SIRIO-VENTILATOR/sirio-hardware/SIRIO v5 INDUSTRIAL/JPG/SIRIO_3D_jpg.JPG

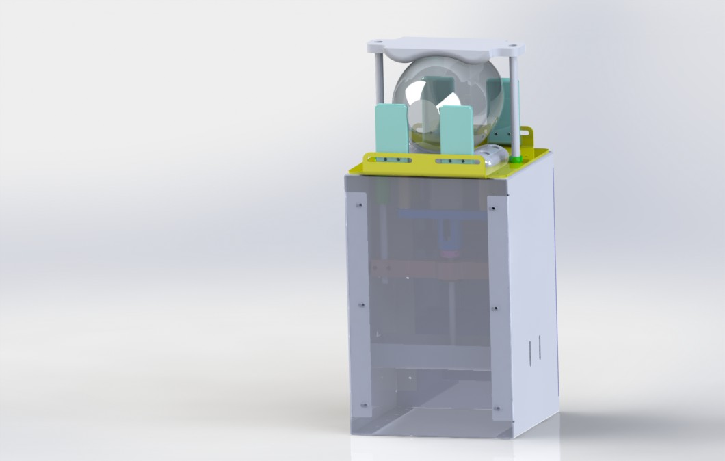
SIRIO v5 INDUSTRIAL/JPG/SIRIO_3D_jpg.JPG
