SIRIO-VENTILATOR/sirio-hardware/SIRIO v5 INDUSTRIAL/JPG/SIRIO_3D_v5_LATERAL.JPG

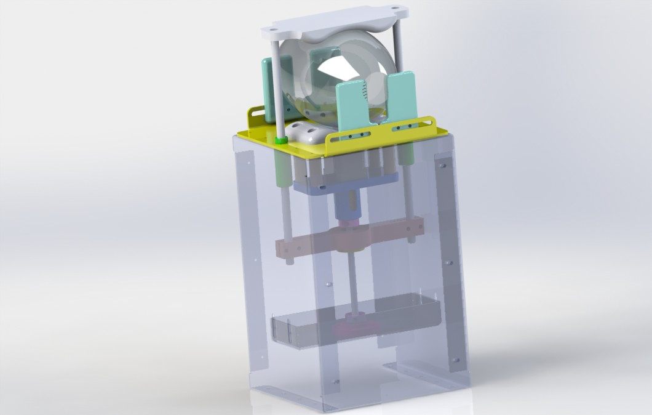
SIRIO v5 INDUSTRIAL/JPG/SIRIO_3D_v5_LATERAL.JPG
