SIRIO-VENTILATOR/sirio-hardware/SIRIO v5 INDUSTRIAL/BOM.md

## INDUSTRIAL VERSION

# BILL OF MATERIALS
