SIRIO-VENTILATOR/sirio-hardware/SIRIO v5 MAKER/STL/MAIN ARM.stl

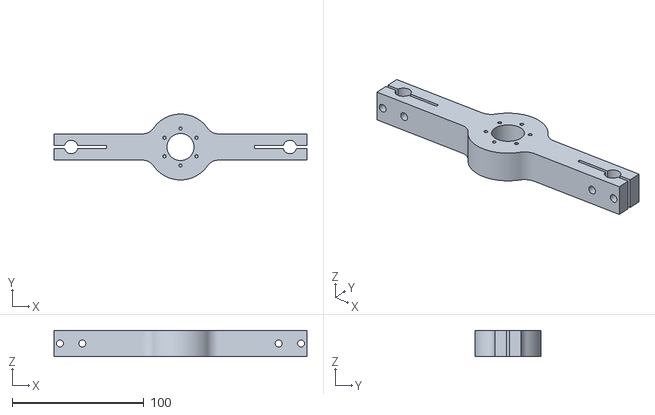
[picture p4: CAD file, 2020-03-29]
SIRIO v5 MAKER/STL/MAIN ARM.stl
192.0 x 50.0 x 20.0
