SIRIO-VENTILATOR/sirio-hardware/SIRIO v5 INDUSTRIAL/SOLIDPART/SIRIO_3D_3.SLDASM

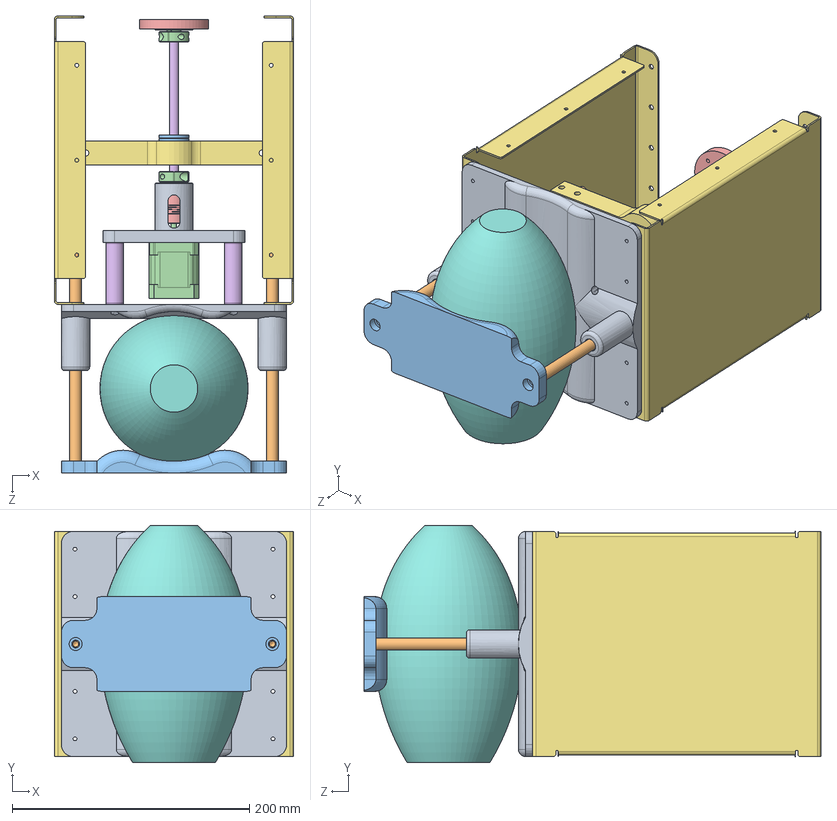
[picture p5: CAD file, 2020-03-29]
SIRIO v5 INDUSTRIAL/SOLIDPART/SIRIO_3D_3.SLDASM
202.0 x 200.0 x 385.6 mm
cuerpo
GUIA x 2
SOPORT_HUSILLO_SUP
Nema17Motor - Copy
Acople FlexibleSLDPRT_Predeterminado
HUSILLO_IGUS_8X15
SOPORTE HUSILLO
AMBU125
SOPORTE_MOTOR
ROD_608 x 2
DST_JFRM_1315DS6_35x25_4_1
collarin x 2
SOPORTE_INFERIOR_HUSILLO
SEPARADOR CILINDRO x 4
LATERAL CAJON x 2
