SIRIO-VENTILATOR/sirio-hardware/SIRIO v5 INDUSTRIAL/SOLIDPART/SIRIO_3D_v5.SLDASM

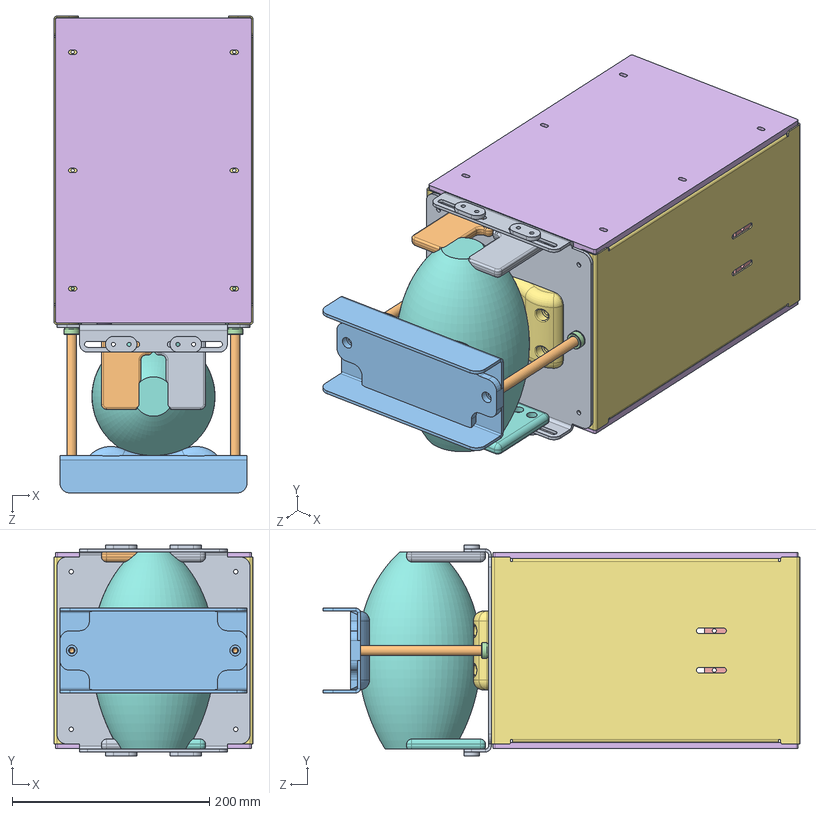
[picture p6: CAD file, 2020-03-29]
SIRIO v5 INDUSTRIAL/SOLIDPART/SIRIO_3D_v5.SLDASM
202.0 x 214.0 x 484.2 mm
cuerpo
GUIA x 2
SOPORT_HUSILLO_SUP
Nema17Motor - Copy
Acople FlexibleSLDPRT_Predeterminado
HUSILLO_IGUS_8X15
SOPORTE HUSILLO
AMBU125
SOPORTE_MOTOR
ROD_728 x 2
DST_JFRM_2020ds8x15
collarin x 2
SOPORTE_INFERIOR_HUSILLO
SEPARADOR CILINDRO x 2
LATERAL CAJON x 2
CENTRADOR
SimetríaCENTRADOR x 2
SimetríaSimetríaCENTRADOR
EMPUJADOR
CAÑONERA x 2
BASE DE HUSILLO
TAPA TRASERA x 2
EMPUJADOR_INFERIOR
TAPA FRONTAL
FIJACION CENTRADOR x 4
