SIRIO-VENTILATOR/sirio-hardware/SIRIO v5 INDUSTRIAL/SOLIDPART/CENTRADOR.SLDPRT

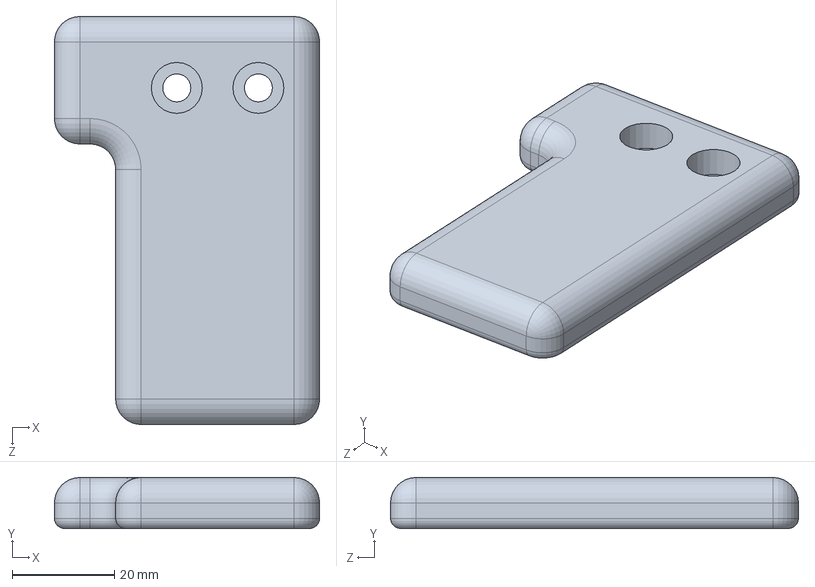
[picture p7: CAD file, 2020-03-29]
SIRIO v5 INDUSTRIAL/SOLIDPART/CENTRADOR.SLDPRT
52.0 x 10.0 x 80.0 mm
