SIRIO-VENTILATOR/sirio-hardware/SIRIO v5 INDUSTRIAL/STEP_SIRIO_V5/CAÑONERA.STL

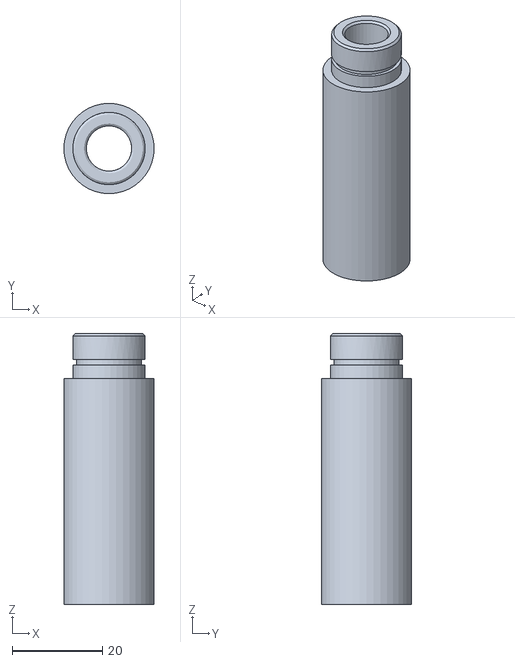
[picture p8: CAD file, 2020-03-29]
SIRIO v5 INDUSTRIAL/STEP_SIRIO_V5/CAÑONERA.STL
20.0 x 20.0 x 60.0
