SIRIO-VENTILATOR/sirio-hardware/SIRIO v5 INDUSTRIAL/STL/CENTRADOR.STL

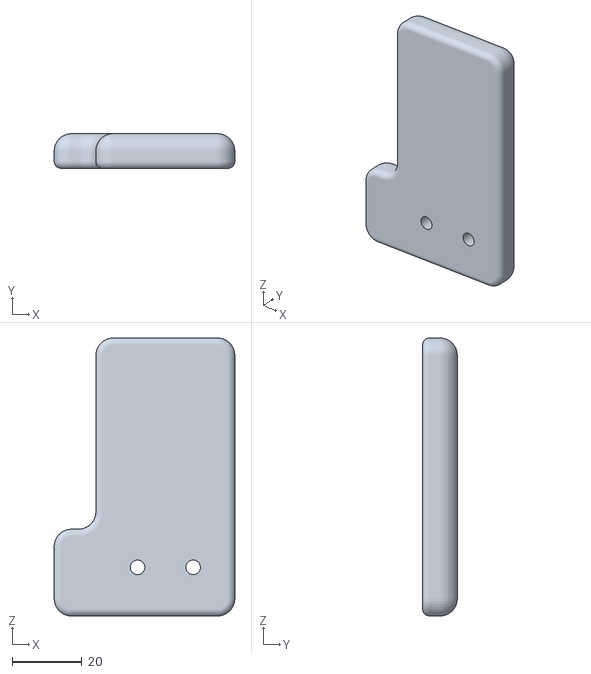
[picture p9: CAD file, 2020-03-29]
SIRIO v5 INDUSTRIAL/STL/CENTRADOR.STL
52.0 x 10.0 x 80.0
