SIRIO-VENTILATOR/sirio-hardware/SIRIO v5 MAKER/LASERCUT/lasercut_case.dxf

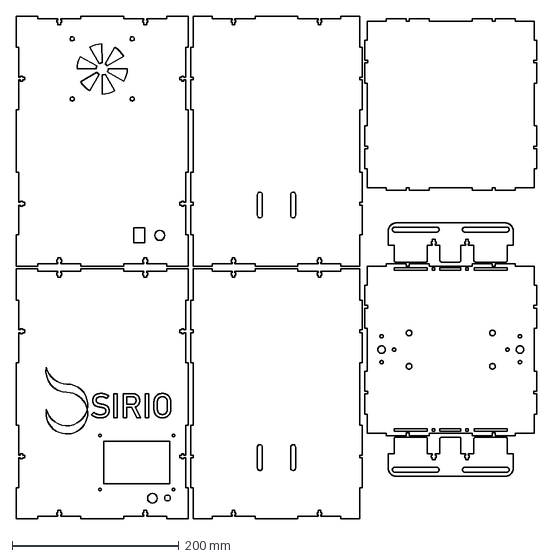
[picture p10: CAD file, 2020-03-29]
SIRIO v5 MAKER/LASERCUT/lasercut_case.dxf
624.0 x 603.0 mm
