SIRIO-VENTILATOR/sirio-hardware/SIRIO v5 INDUSTRIAL/SOLIDPART/TAPA TRASERA.SLDPRT

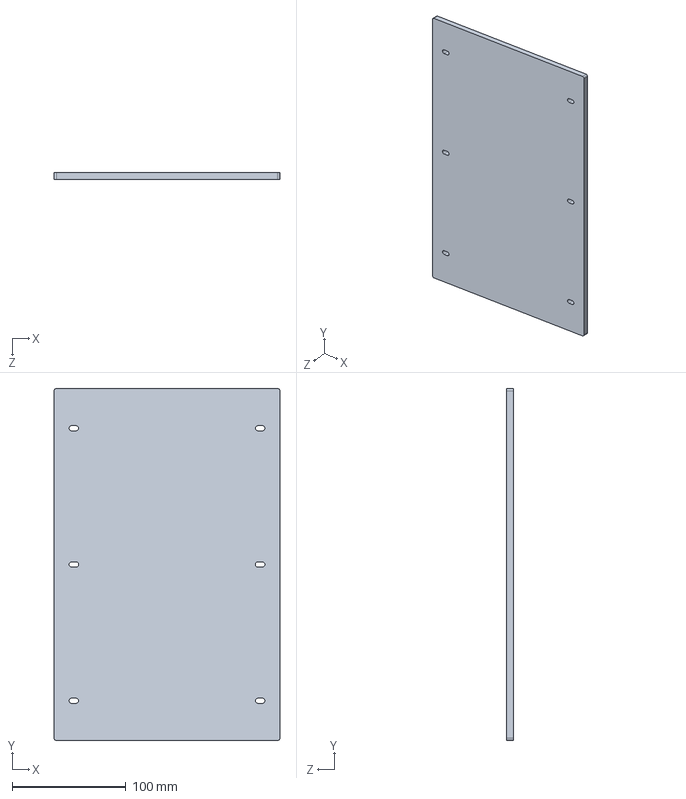
[picture p11: CAD file, 2020-03-29]
SIRIO v5 INDUSTRIAL/SOLIDPART/TAPA TRASERA.SLDPRT
199.0 x 310.0 x 6.00 mm
