SIRIO-VENTILATOR/sirio-hardware/SIRIO v5 INDUSTRIAL/STL/SOPORTE_MOTORstl.STL

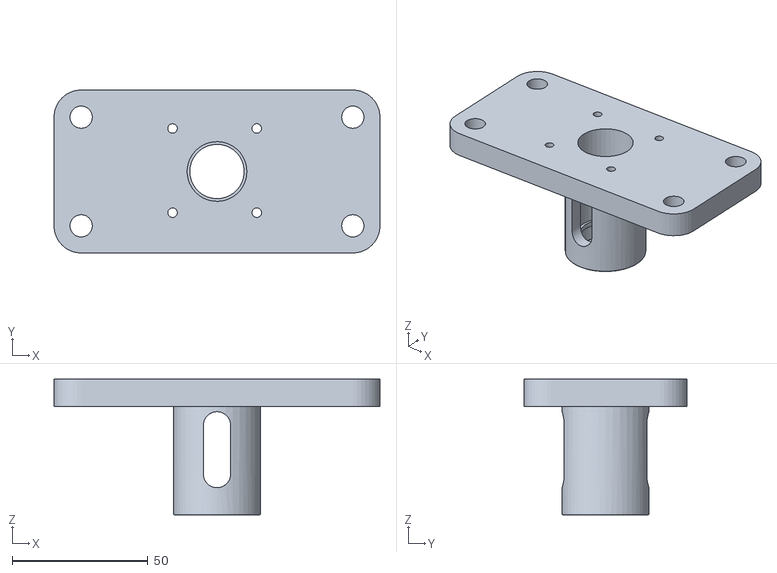
[picture p12: CAD file, 2020-03-29]
SIRIO v5 INDUSTRIAL/STL/SOPORTE_MOTORstl.STL
120.0 x 60.0 x 50.0
