SIRIO-VENTILATOR/sirio-hardware/SIRIO v5 MAKER/STL/ROD GUIDE RIGHT.stl

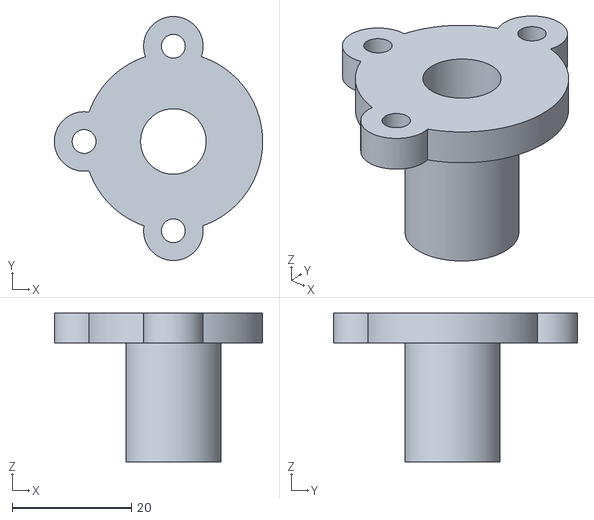
[picture p13: CAD file, 2020-03-29]
SIRIO v5 MAKER/STL/ROD GUIDE RIGHT.stl
35.0 x 41.0 x 25.0
