SIRIO-VENTILATOR/sirio-hardware/SIRIO v5 INDUSTRIAL/SOLIDPART/cuerpo.SLDPRT

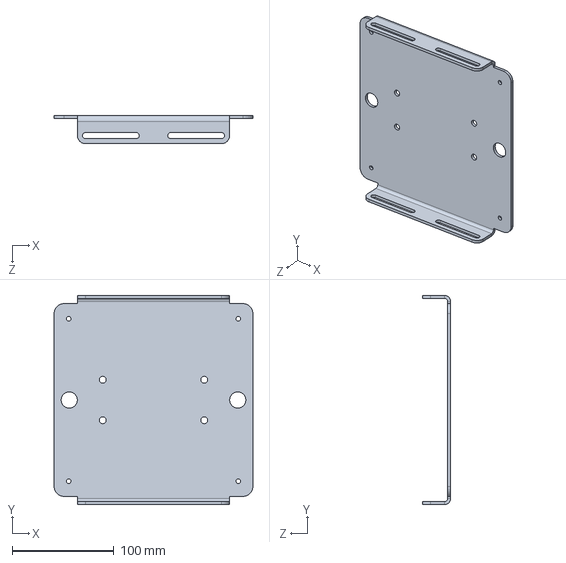
[picture p14: CAD file, 2020-03-29]
SIRIO v5 INDUSTRIAL/SOLIDPART/cuerpo.SLDPRT
196.0 x 206.0 x 28.0 mm
