SIRIO-VENTILATOR/sirio-hardware/SIRIO v5 INDUSTRIAL/SOLIDPART/DST_JFRM_2020ds8x15.SLDPRT

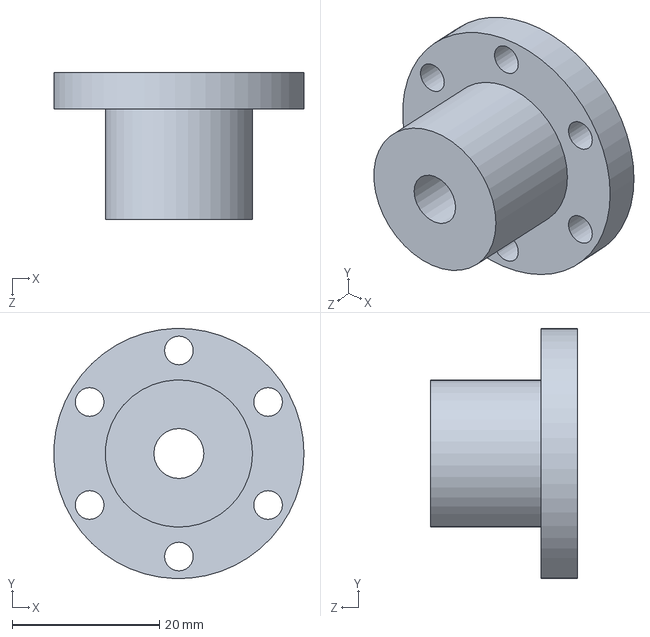
[picture p15: CAD file, 2020-03-29]
SIRIO v5 INDUSTRIAL/SOLIDPART/DST_JFRM_2020ds8x15.SLDPRT
34.0 x 34.0 x 20.0 mm
