SIRIO-VENTILATOR/sirio-hardware/SIRIO v5 MAKER/STL/AMBU LOWER WITH GUIDES.stl

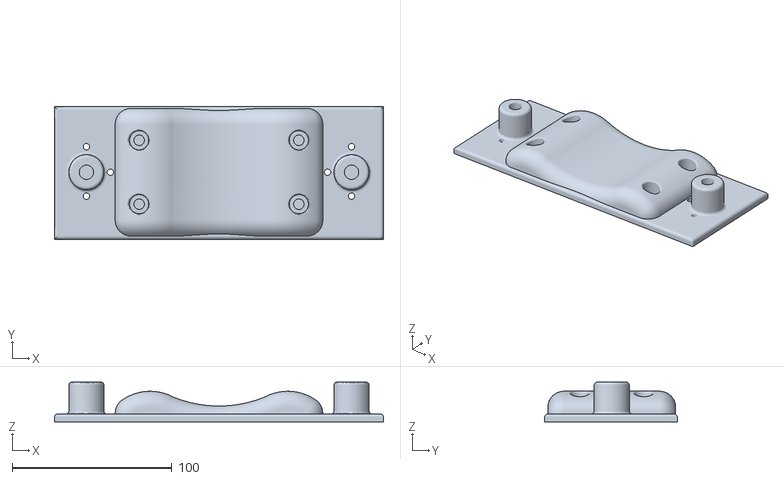
[picture p16: CAD file, 2020-03-29]
SIRIO v5 MAKER/STL/AMBU LOWER WITH GUIDES.stl
206.0 x 83.1 x 25.0
