SIRIO-VENTILATOR/sirio-hardware/SIRIO v5 MAKER/STL/MOTOR SUPPORT.stl

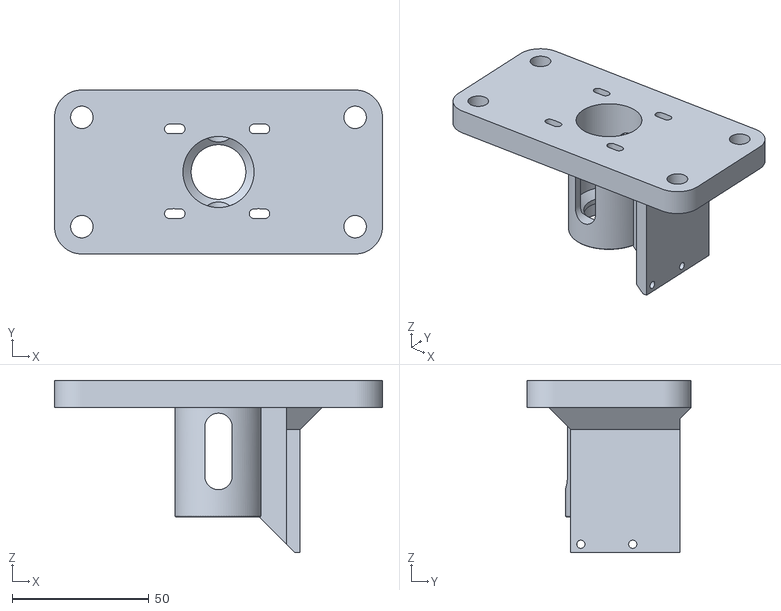
[picture p17: CAD file, 2020-03-29]
SIRIO v5 MAKER/STL/MOTOR SUPPORT.stl
120.0 x 60.0 x 63.0
