SIRIO-VENTILATOR/sirio-hardware/SIRIO v5 MAKER/STL/AMBU LOWER_SMALL.stl

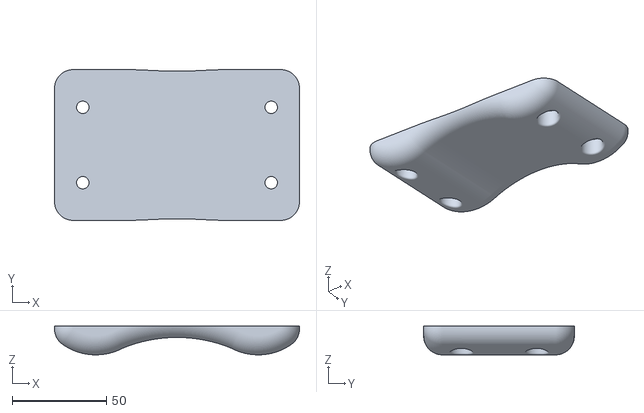
[picture p18: CAD file, 2020-03-29]
SIRIO v5 MAKER/STL/AMBU LOWER_SMALL.stl
130.0 x 80.0 x 15.2
