SIRIO-VENTILATOR/sirio-hardware/SIRIO v5 INDUSTRIAL/SOLIDPART/LATERAL CAJON.SLDPRT

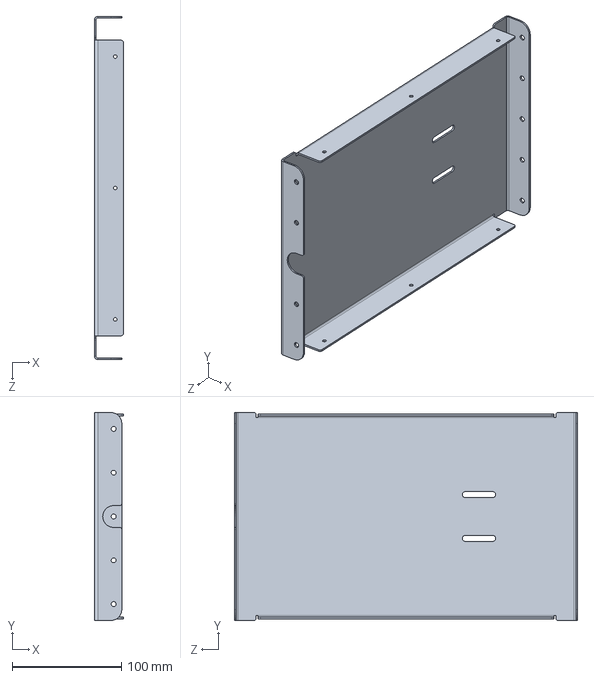
[picture p19: CAD file, 2020-03-29]
SIRIO v5 INDUSTRIAL/SOLIDPART/LATERAL CAJON.SLDPRT
26.5 x 190.0 x 313.3 mm
