SIRIO-VENTILATOR/sirio-hardware/SIRIO v5 MAKER/STL/COLLAR_x2.stl

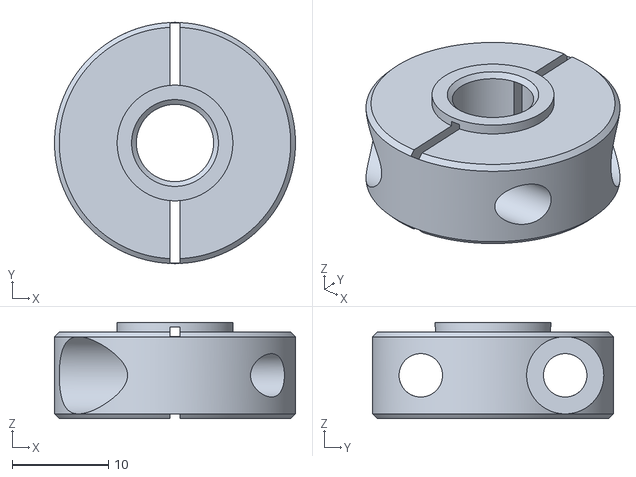
[picture p20: CAD file, 2020-03-29]
SIRIO v5 MAKER/STL/COLLAR_x2.stl
25.0 x 25.0 x 10.0
