SIRIO-VENTILATOR/sirio-hardware/SIRIO v5 INDUSTRIAL/SOLIDPART/SEPARADOR CILINDRO.SLDPRT

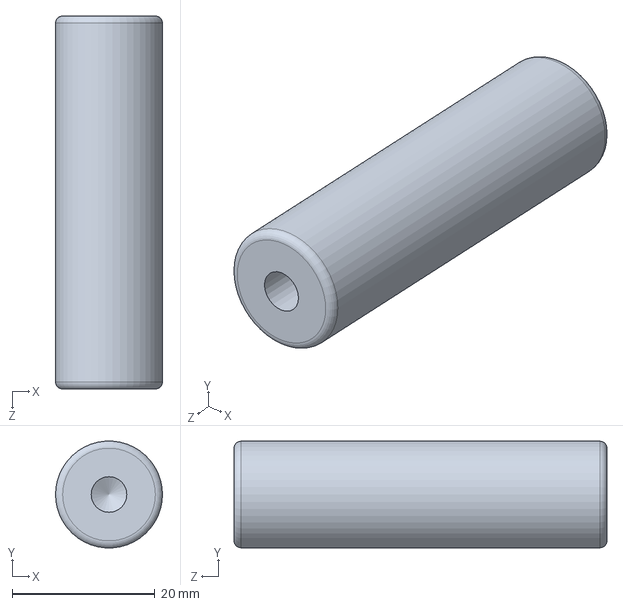
[picture p21: CAD file, 2020-03-29]
SIRIO v5 INDUSTRIAL/SOLIDPART/SEPARADOR CILINDRO.SLDPRT
15.0 x 15.0 x 52.3 mm
