SIRIO-VENTILATOR/sirio-hardware/SIRIO v5 MAKER/STL/AMBU UPPER SUPPORT.stl

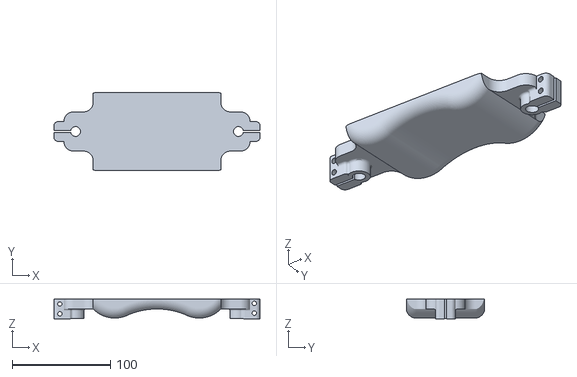
[picture p22: CAD file, 2020-03-29]
SIRIO v5 MAKER/STL/AMBU UPPER SUPPORT.stl
210.0 x 80.0 x 20.0
