SIRIO-VENTILATOR/sirio-hardware/SIRIO v5 INDUSTRIAL/SOLIDPART/SOPORTE HUSILLO.SLDPRT

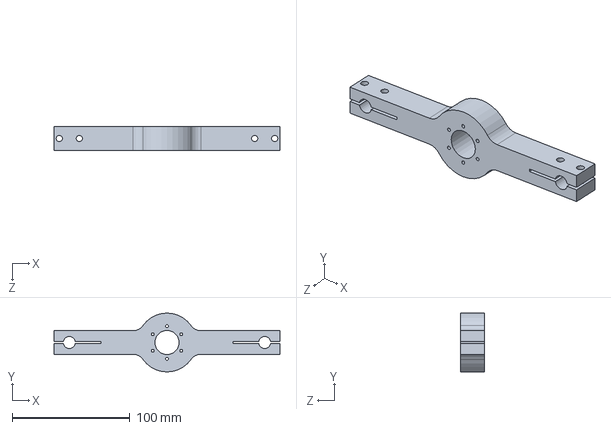
[picture p23: CAD file, 2020-03-29]
SIRIO v5 INDUSTRIAL/SOLIDPART/SOPORTE HUSILLO.SLDPRT
192.0 x 50.0 x 20.0 mm
