SIRIO-VENTILATOR/sirio-hardware/SIRIO v5 MAKER/STL/MOTOR SEPARATOR_x4.stl

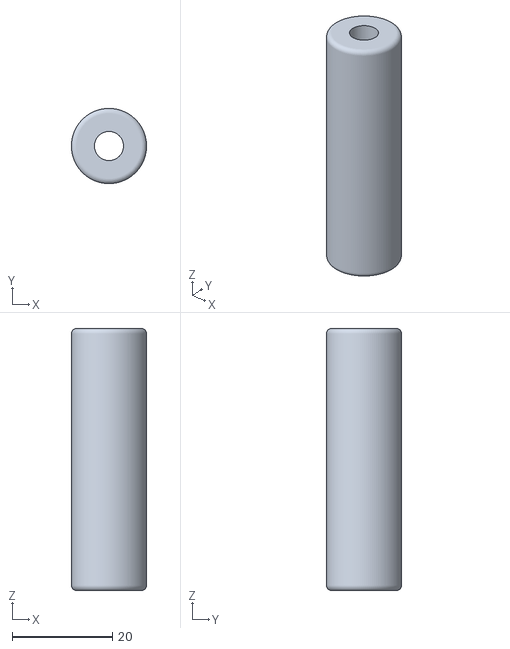
[picture p24: CAD file, 2020-03-29]
SIRIO v5 MAKER/STL/MOTOR SEPARATOR_x4.stl
15.0 x 15.0 x 52.3
