SIRIO-VENTILATOR/sirio-hardware/SIRIO v5 INDUSTRIAL/SOLIDPART/AMBU125.SLDPRT

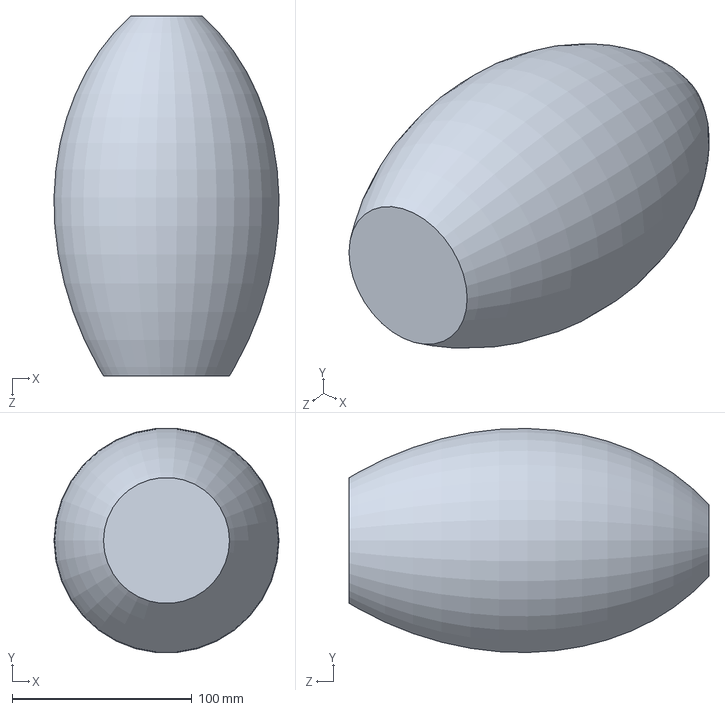
[picture p25: CAD file, 2020-03-29]
SIRIO v5 INDUSTRIAL/SOLIDPART/AMBU125.SLDPRT
125.0 x 124.5 x 200.0 mm
