SIRIO-VENTILATOR/sirio-hardware/SIRIO v5 MAKER/STL/LCD_Knob_Set.stl

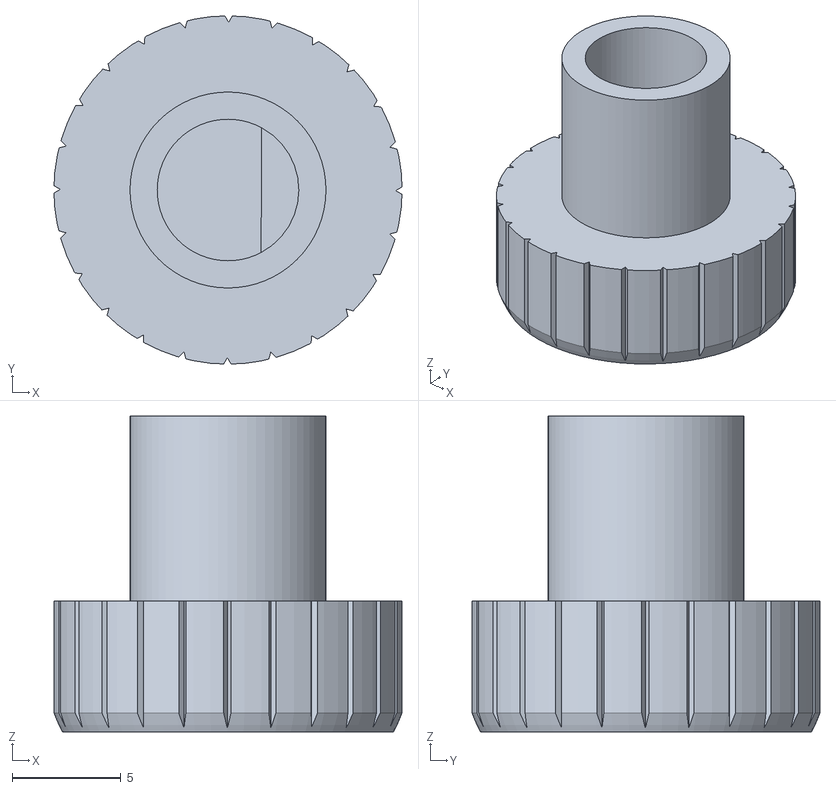
[picture p26: CAD file, 2020-03-29]
SIRIO v5 MAKER/STL/LCD_Knob_Set.stl
16.0 x 16.0 x 14.5
