SIRIO-VENTILATOR/sirio-hardware/SIRIO v5 INDUSTRIAL/SOLIDPART/ROD_7000.SLDPRT

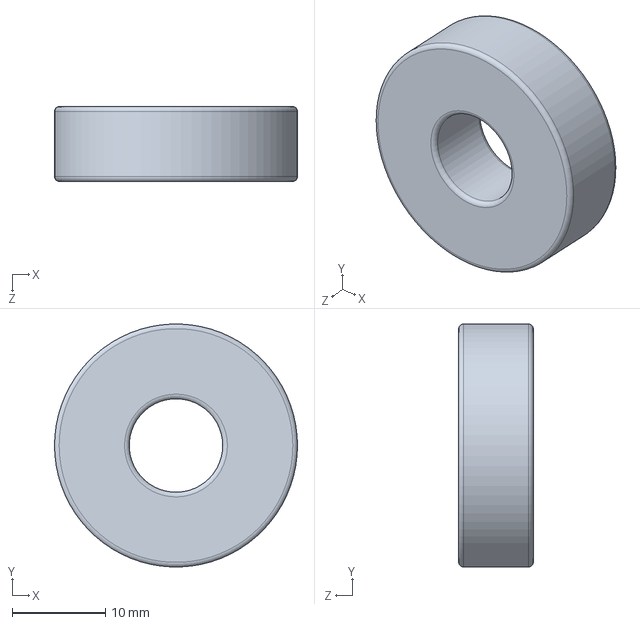
[picture p27: CAD file, 2020-03-29]
SIRIO v5 INDUSTRIAL/SOLIDPART/ROD_7000.SLDPRT
26.0 x 26.0 x 8.00 mm
