SIRIO-VENTILATOR/sirio-hardware/SIRIO v5 INDUSTRIAL/SOLIDPART/HUSILLO_IGUS_8X15.SLDPRT

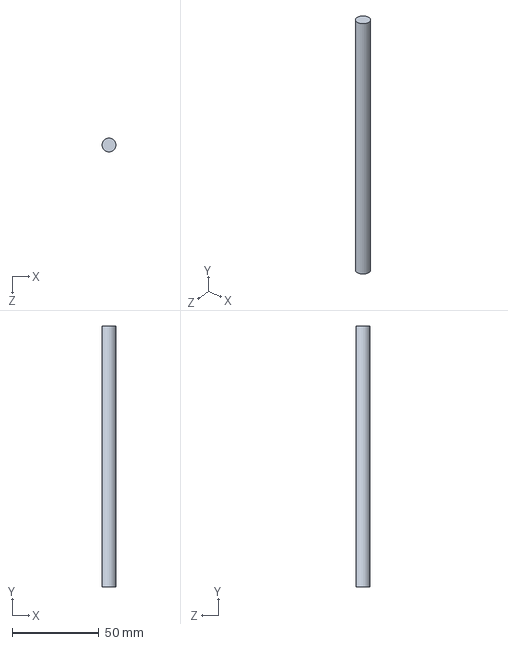
[picture p28: CAD file, 2020-03-29]
SIRIO v5 INDUSTRIAL/SOLIDPART/HUSILLO_IGUS_8X15.SLDPRT
8.00 x 150.0 x 8.00 mm
