SIRIO-VENTILATOR/sirio-hardware/SIRIO v5 INDUSTRIAL/SOLIDPART/SOPORT_HUSILLO_SUP.SLDPRT

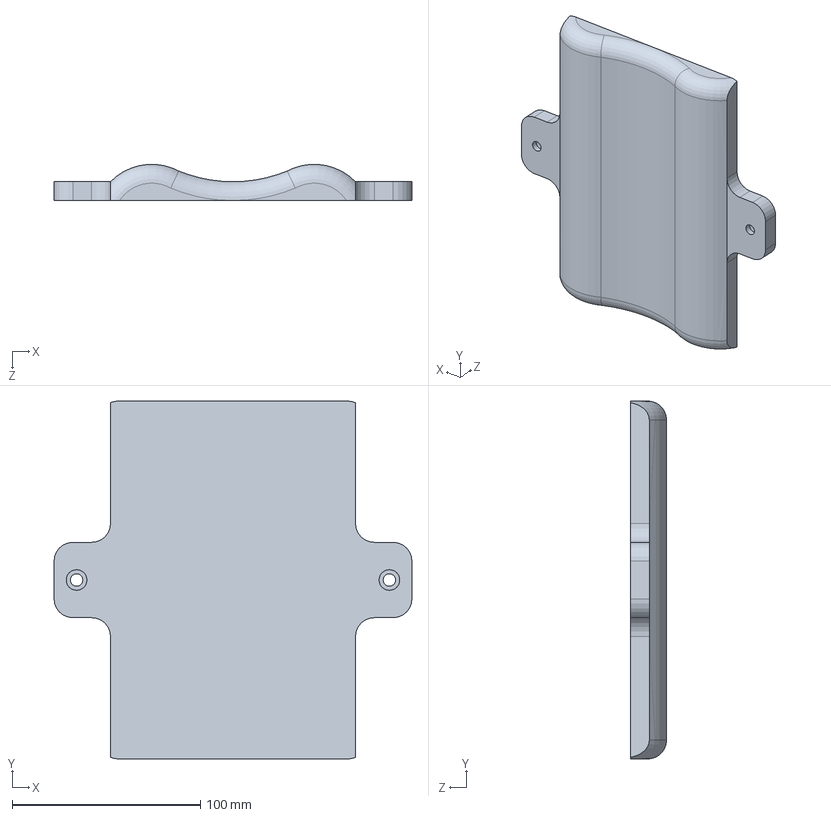
[picture p29: CAD file, 2020-03-29]
SIRIO v5 INDUSTRIAL/SOLIDPART/SOPORT_HUSILLO_SUP.SLDPRT
190.0 x 190.0 x 19.2 mm
