SIRIO-VENTILATOR/sirio-hardware/SIRIO v5 INDUSTRIAL/SOLIDPART/Nema17Motor - Copy.sldprt

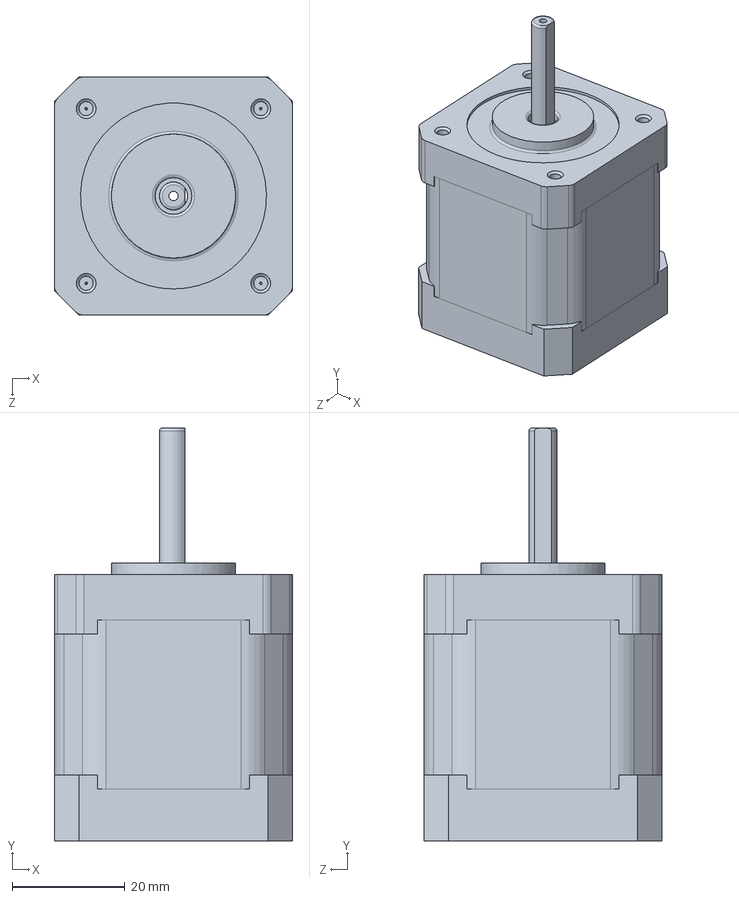
[picture p30: CAD file, 2020-03-29]
SIRIO v5 INDUSTRIAL/SOLIDPART/Nema17Motor - Copy.sldprt
42.3 x 73.3 x 42.3 mm
