SIRIO-VENTILATOR/sirio-hardware/SIRIO v5 INDUSTRIAL/SOLIDPART/SimetríaCENTRADOR.SLDPRT

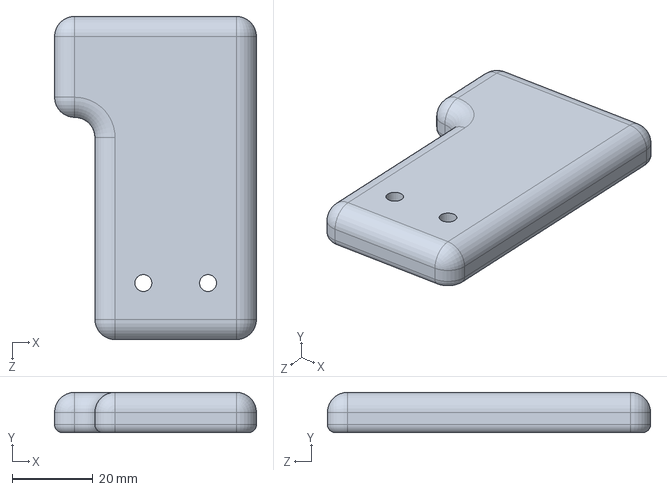
[picture p31: CAD file, 2020-03-29]
SIRIO v5 INDUSTRIAL/SOLIDPART/SimetríaCENTRADOR.SLDPRT
50.0 x 10.0 x 80.0 mm
