SIRIO-VENTILATOR/sirio-hardware/SIRIO v5 INDUSTRIAL/SOLIDPART/ROD_608.SLDPRT

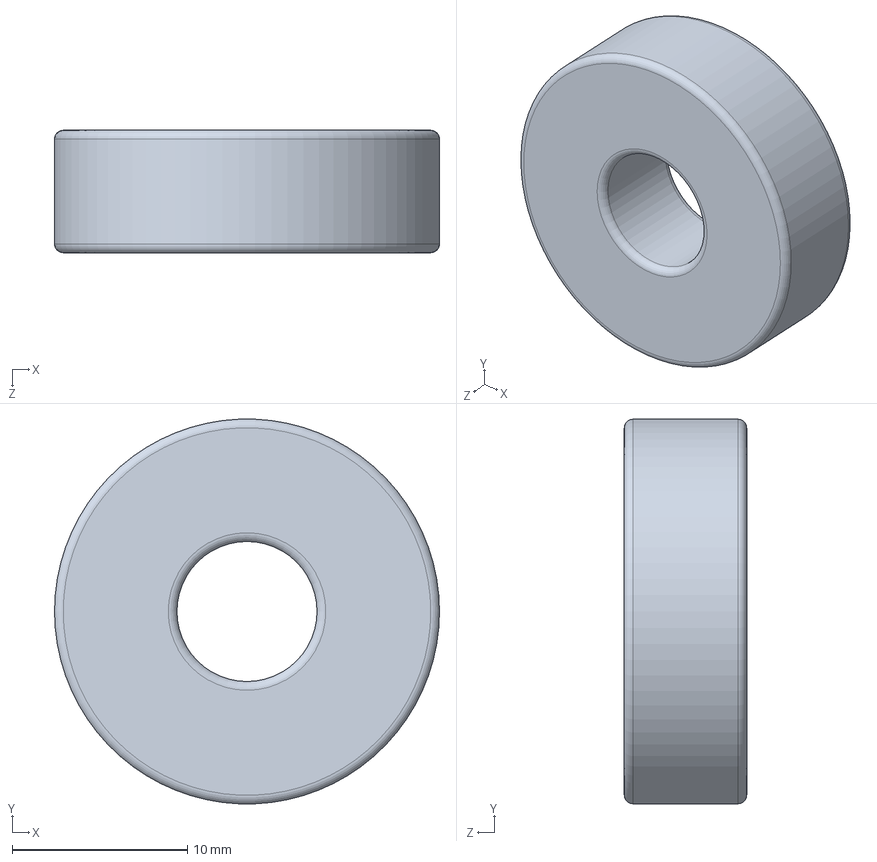
[picture p32: CAD file, 2020-03-29]
SIRIO v5 INDUSTRIAL/SOLIDPART/ROD_608.SLDPRT
22.0 x 22.0 x 7.00 mm
