SIRIO-VENTILATOR/sirio-hardware/SIRIO v5 INDUSTRIAL/SOLIDPART/SOPORTE_INFERIOR_HUSILLO.SLDPRT

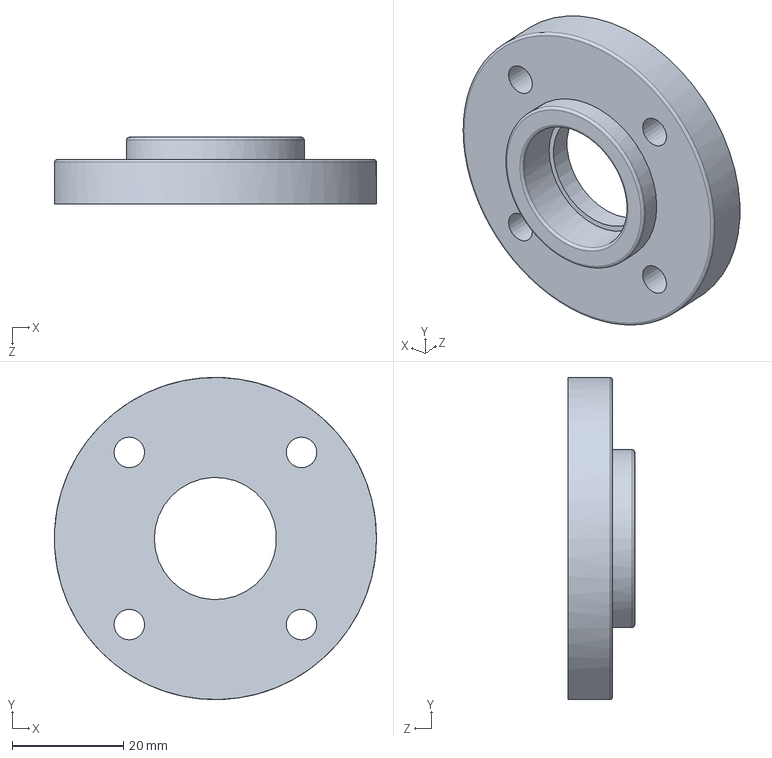
[picture p33: CAD file, 2020-03-29]
SIRIO v5 INDUSTRIAL/SOLIDPART/SOPORTE_INFERIOR_HUSILLO.SLDPRT
58.0 x 58.0 x 12.0 mm
