SIRIO-VENTILATOR/sirio-hardware/SIRIO v5 INDUSTRIAL/SOLIDPART/Acople FlexibleSLDPRT_Predeterminado.sldprt

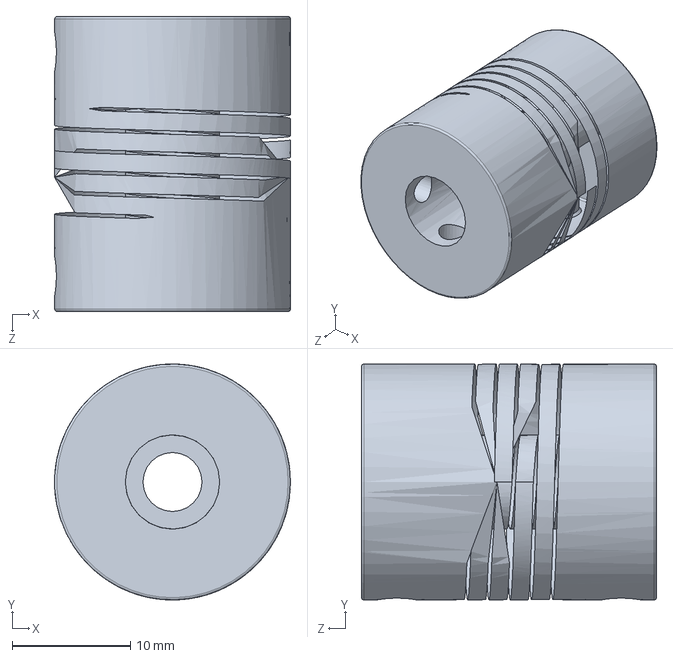
[picture p34: CAD file, 2020-03-29]
SIRIO v5 INDUSTRIAL/SOLIDPART/Acople FlexibleSLDPRT_Predeterminado.sldprt
20.0 x 20.0 x 25.0 mm
