SIRIO-VENTILATOR/sirio-hardware/SIRIO v5 INDUSTRIAL/SOLIDPART/EMPUJADOR.SLDPRT

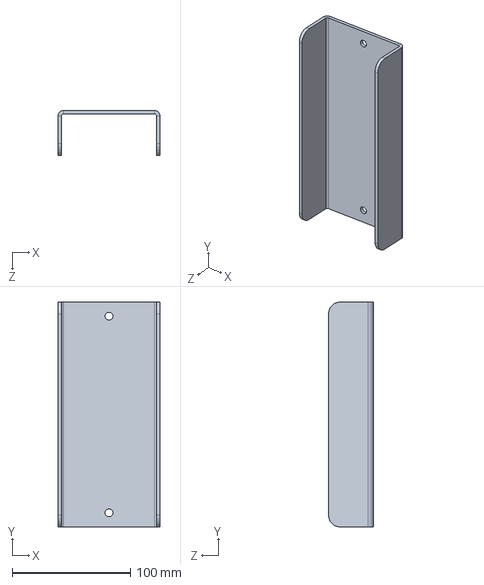
[picture p35: CAD file, 2020-03-29]
SIRIO v5 INDUSTRIAL/SOLIDPART/EMPUJADOR.SLDPRT
86.0 x 190.0 x 38.0 mm
