SIRIO-VENTILATOR/sirio-hardware/SIRIO v5 INDUSTRIAL/SOLIDPART/ROD_728.SLDPRT

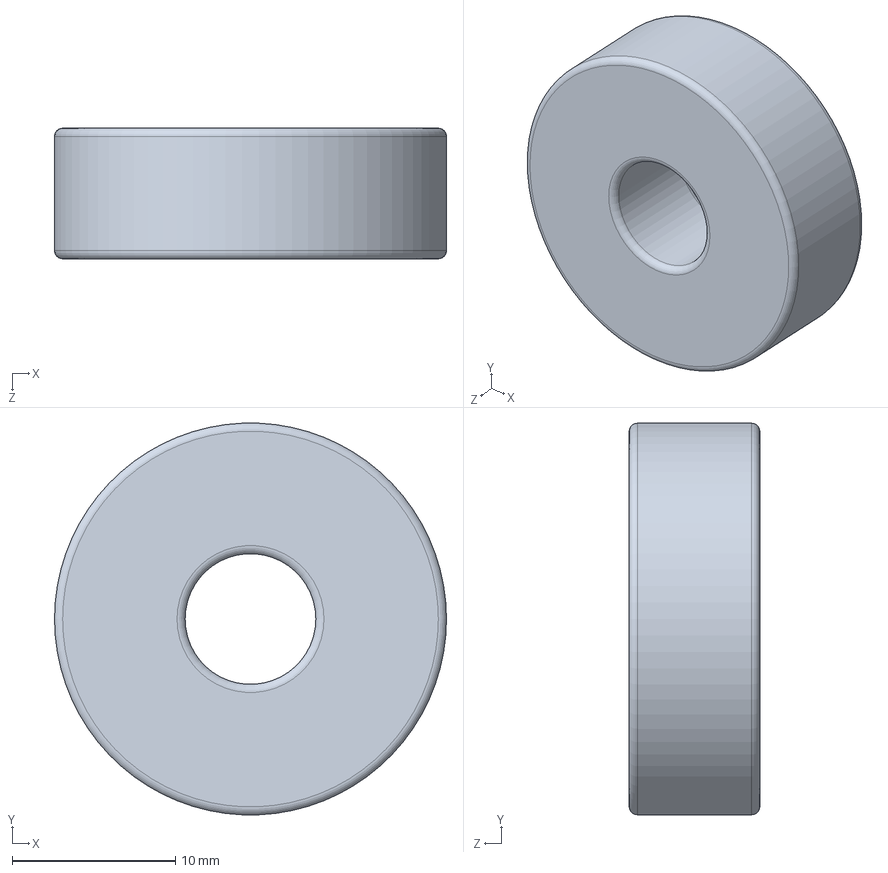
[picture p36: CAD file, 2020-03-29]
SIRIO v5 INDUSTRIAL/SOLIDPART/ROD_728.SLDPRT
24.0 x 24.0 x 8.00 mm
