SIRIO-VENTILATOR/sirio-hardware/SIRIO v5 INDUSTRIAL/SOLIDPART/BASE DE HUSILLO.SLDPRT

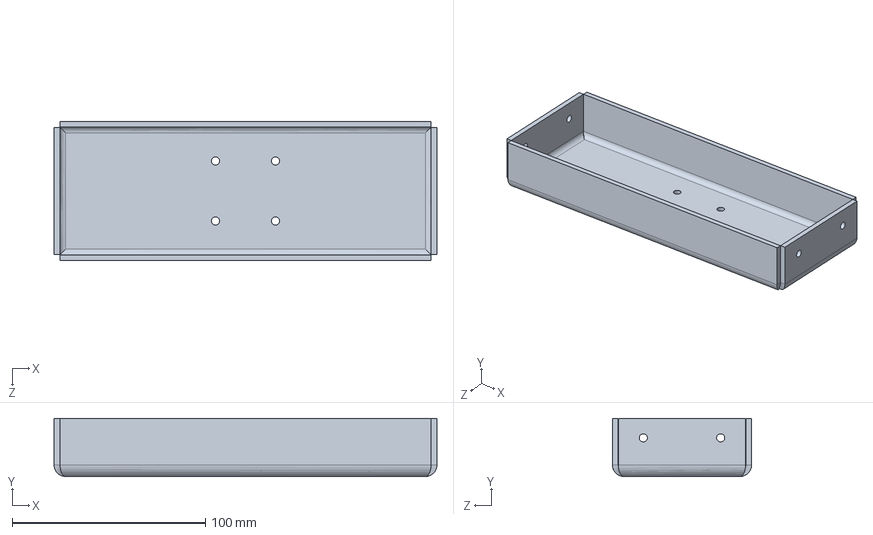
[picture p37: CAD file, 2020-03-29]
SIRIO v5 INDUSTRIAL/SOLIDPART/BASE DE HUSILLO.SLDPRT
198.0 x 30.0 x 72.0 mm
