SIRIO-VENTILATOR/sirio-hardware/SIRIO v5 INDUSTRIAL/SOLIDPART/GUIA.SLDPRT

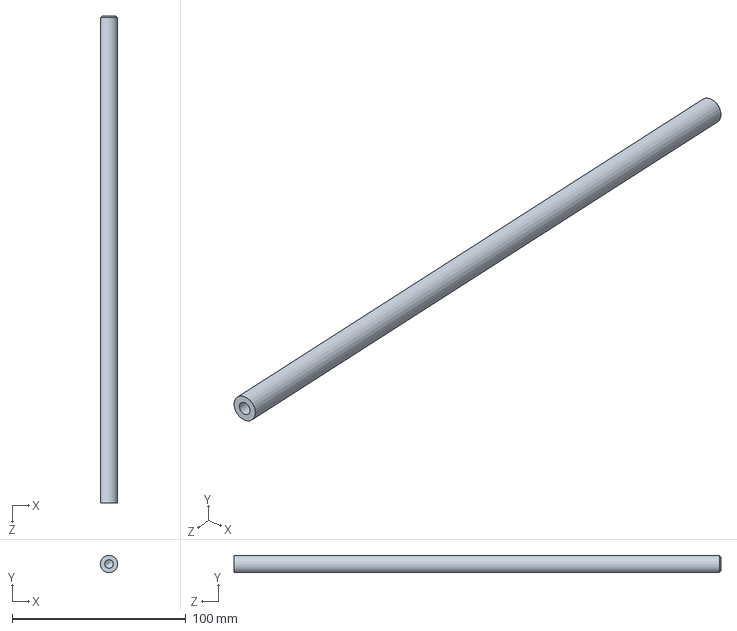
[picture p38: CAD file, 2020-03-29]
SIRIO v5 INDUSTRIAL/SOLIDPART/GUIA.SLDPRT
10.0 x 10.0 x 280.0 mm
