SIRIO-VENTILATOR/sirio-hardware/(list of files, cad)

Other CAD files:
SIRIO v5 INDUSTRIAL/DWGs/laser/CUERPO.DWG
SIRIO v5 INDUSTRIAL/DWGs/TAPA FRONTAL.DWG
SIRIO v5 MAKER/STL/AMBU CENTER LEFT_x2.stl
SIRIO v5 INDUSTRIAL/DWGs/laser/BASE DE HUSILLO.DWG
SIRIO v5 INDUSTRIAL/DWGs/SOPORTE HUSILLO.DWG
SIRIO v5 INDUSTRIAL/STEP_SIRIO_V5/SOPORTE PANTALLA2.STEP
SIRIO v5 INDUSTRIAL/DWGs/laser/CENTRADOR.DWG
SIRIO v5 MAKER/STL/AMBU CENTER RIGHT_x2.stl
SIRIO v5 INDUSTRIAL/DWGs/DST_JFRM_1315DS6_35x25_4_1.DWG
SIRIO v5 INDUSTRIAL/DWGs/laser/LATERAL CAJON.DWG
SIRIO v5 INDUSTRIAL/SOLIDPART/SOPORTE PANTALLA2.SLDPRT
SIRIO v5 INDUSTRIAL/DWGs/laser/EMPUJADOR.DWG
SIRIO v5 INDUSTRIAL/DWGs/LATERAL CAJON.DWG
SIRIO v5 INDUSTRIAL/DWGs/laser/TAPA FRONTAL.DWG
SIRIO v5 INDUSTRIAL/DWGs/ROD_608.DWG
SIRIO v5 MAKER/STL/ROD GUIDE LEFT.stl
SIRIO v5 INDUSTRIAL/DWGs/collarin.DWG
SIRIO v5 INDUSTRIAL/SOLIDPART/DST_JFRM_1315DS6_35x25_4_1.sldprt
SIRIO v5 INDUSTRIAL/DWGs/SEPARADOR CILINDRO.DWG
SIRIO v5 INDUSTRIAL/DWGs/SOPORT_HUSILLO_SUP.DWG
SIRIO v5 INDUSTRIAL/DWGs/Acople FlexibleSLDPRT_Predeterminado.DWG
SIRIO v5 INDUSTRIAL/DWGs/EMPUJADOR.DWG
SIRIO v5 INDUSTRIAL/SOLIDPART/SOPORTE_MOTOR.SLDPRT
SIRIO v5 MAKER/STL/COLLAR.stl
SIRIO v5 INDUSTRIAL/DWGs/cuerpo.DWG
SIRIO v5 INDUSTRIAL/DWGs/SOPORTE_INFERIOR_HUSILLO.DWG
SIRIO v5 INDUSTRIAL/DWGs/BASE DE HUSILLO.DWG
SIRIO v5 INDUSTRIAL/SOLIDPART/TAPA FRONTAL.SLDPRT
SIRIO v5 INDUSTRIAL/DWGs/Nema17Motor - Copy.DWG
SIRIO v5 INDUSTRIAL/DWGs/GUIA.DWG
SIRIO v5 INDUSTRIAL/SOLIDPART/EMPUJADOR_INFERIOR.SLDPRT
SIRIO v5 INDUSTRIAL/SOLIDPART/SimetríaSimetríaCENTRADOR.SLDPRT
SIRIO v5 INDUSTRIAL/SOLIDPART/SOPORTE PANTALLA.SLDPRT
SIRIO v5 INDUSTRIAL/SOLIDPART/collarin.SLDPRT
SIRIO v5 INDUSTRIAL/SOLIDPART/CAÑONERA.SLDPRT
SIRIO v5 INDUSTRIAL/DWGs/CENTRADOR.DWG
SIRIO v5 INDUSTRIAL/DWGs/EMPUJADOR copia.DWG
SIRIO v5 INDUSTRIAL/DWGs/cuerpo copia.DWG
SIRIO v5 INDUSTRIAL/PDFs/FIJACION CENTRADOR.SLDDRW
SIRIO v5 INDUSTRIAL/SOLIDPART/12864_LCD_Graphic_Smart_Display_Controller_Board_Case_4MAX_v2 (2).SLDPRT
SIRIO v5 INDUSTRIAL/SOLIDPART/Acople FlexibleSLDPRT_Predeterminado.SLDDRW
SIRIO v5 INDUSTRIAL/SOLIDPART/BASE DE HUSILLO.SLDDRW
SIRIO v5 INDUSTRIAL/SOLIDPART/CAÑONERA.SLDDRW
SIRIO v5 INDUSTRIAL/SOLIDPART/CENTRADOR.SLDDRW
SIRIO v5 INDUSTRIAL/SOLIDPART/DST_JFRM_1315DS6_35x25_4_1.SLDDRW
SIRIO v5 INDUSTRIAL/SOLIDPART/DST_JFRM_2020ds8x15.SLDDRW
SIRIO v5 INDUSTRIAL/SOLIDPART/EMPUJADOR.SLDDRW
SIRIO v5 INDUSTRIAL/SOLIDPART/EMPUJADOR_INFERIOR.SLDDRW
SIRIO v5 INDUSTRIAL/SOLIDPART/GUIA.SLDDRW
SIRIO v5 INDUSTRIAL/SOLIDPART/HUSILLO_IGUS_8X15.SLDDRW
SIRIO v5 INDUSTRIAL/SOLIDPART/LATERAL CAJON.SLDDRW
SIRIO v5 INDUSTRIAL/SOLIDPART/Nema17Motor - Copy.SLDDRW
SIRIO v5 INDUSTRIAL/SOLIDPART/ROD_608.SLDDRW
SIRIO v5 INDUSTRIAL/SOLIDPART/ROD_728.SLDDRW
SIRIO v5 INDUSTRIAL/SOLIDPART/SEPARADOR CILINDRO.SLDDRW
SIRIO v5 INDUSTRIAL/SOLIDPART/SOPORTE HUSILLO.SLDDRW
SIRIO v5 INDUSTRIAL/SOLIDPART/SOPORTE_INFERIOR_HUSILLO.SLDDRW
SIRIO v5 INDUSTRIAL/SOLIDPART/SOPORTE_MOTOR.SLDDRW
SIRIO v5 INDUSTRIAL/SOLIDPART/SOPORT_HUSILLO_SUP.SLDDRW
SIRIO v5 INDUSTRIAL/SOLIDPART/TAPA FRONTAL.SLDDRW
SIRIO v5 INDUSTRIAL/SOLIDPART/collarin.SLDDRW
SIRIO v5 INDUSTRIAL/SOLIDPART/cuerpo.SLDDRW
SIRIO v5 INDUSTRIAL/SOLIDPART/~�12864_LCD_Graphic_Smart_Display_Controller_Board_Case_4MAX_v2 (2).SLDPRT
SIRIO v5 INDUSTRIAL/STL/12864_LCD_Graphic_Smart_Display_Controller_Board_Case_4MAX_v2 (2).stl
SIRIO v5 MAKER/LASERCUT/Lasercut_3mm.3dm
SIRIO v5 MAKER/STL/BOTTOM SCREW SUPPORT.stl
