SIRIO-VENTILATOR/sirio-hardware/SIRIO v5 MAKER/README.md

## MAKER VERSION

# BILL OF MATERIALS

- 1x 1kg Filament PLA or PETG or ABS
- 1x Acrylic 3mm thickness
- 1x stepper motor NEMA 17
- 2x Sainless steel rod 8mm
- 30x M3x10 screw + nuts
- 8x M6x30 screws 
- 12x M4x30 screws + nuts
- 1x Flex coupler 5mm to 8mm
- 1x IGUS ds8x15  150mm 
- 1x IGUS DST_JFRM_2020ds8x15
- 2x 608 Bearings
- 1x Endstop with PCB
- 1x RAMPS shield + Aruino Mega 2560
- 1x 12864_LCD_Graphic_Smart_Display
- 1x 80mm PC Fan

https://www.youtube.com/watch?v=ScqfPxfUaf0
