SIRIO-VENTILATOR/sirio-hardware/SIRIO v5 MAKER/VALVE/README.md

## VALVULA UNIDIRECCIONAL

<p align="center">

</p>

# Neumatica 
El sistema de válvulas unidireccionales se realizó en una primera versión directamente todo en PLA. Conforme fuimos avanzando, nos dimos cuenta de ciertos aspectos para mejorar tanto la impresión, como la estanqueidad del conjunto, tomando la decisión de incorporar una ranura para una junta tórica que asegurara el cierre hermético en la dirección de bloqueo, y mejorando la calidad del obturador disminuyendo la altura de capa en la impresión.El sistema ha sido diseñado con racores para tubo de 22mm flexible. Tras seis diseños sucesivos, logramos conseguir un sistema funcional que consta de las siguientes piezas y características:

Válvula (cuerpo inferior):

<p align="center">

</p>

Layer height (Altura de capa): 0.2
Perimeters (Líneas perimetrales): 5
Infill (Densidad de relleno): 50%

Impresión sin soportes en la misma disposición que en la foto.

Válvula (cuerpo superior):

<p align="center">

</p>

Layer height (Altura de capa): 0.2
Perimeters (Líneas perimetrales): 5
Infill (Densidad de relleno): 50%

Impresión sin soportes en la misma disposición que en la foto.

<p align="center">

</p>

Obturador:

Layer height (Altura de capa): 0.1
Perimeters (Líneas perimetrales): 2
Infill (Densidad de relleno): 100%

Impresión sin soportes en la misma disposición que en la foto.

El obturador ha de completarse con una junta tórica de 19mm de Diámetro interior y 2.5 mm de grosor.

Collarín soporte:

<p align="center">

</p>

Layer height (Altura de capa): 0.2
Perimeters (Líneas perimetrales): 5
Infill (Densidad de relleno): 50%

Impresión sin soportes en la misma disposición que en la foto.
