SIRIO-VENTILATOR/sirio-hardware/SIRIO v5 INDUSTRIAL/PDFs/Acople FlexibleSLDPRT_Predeterminado.PDF

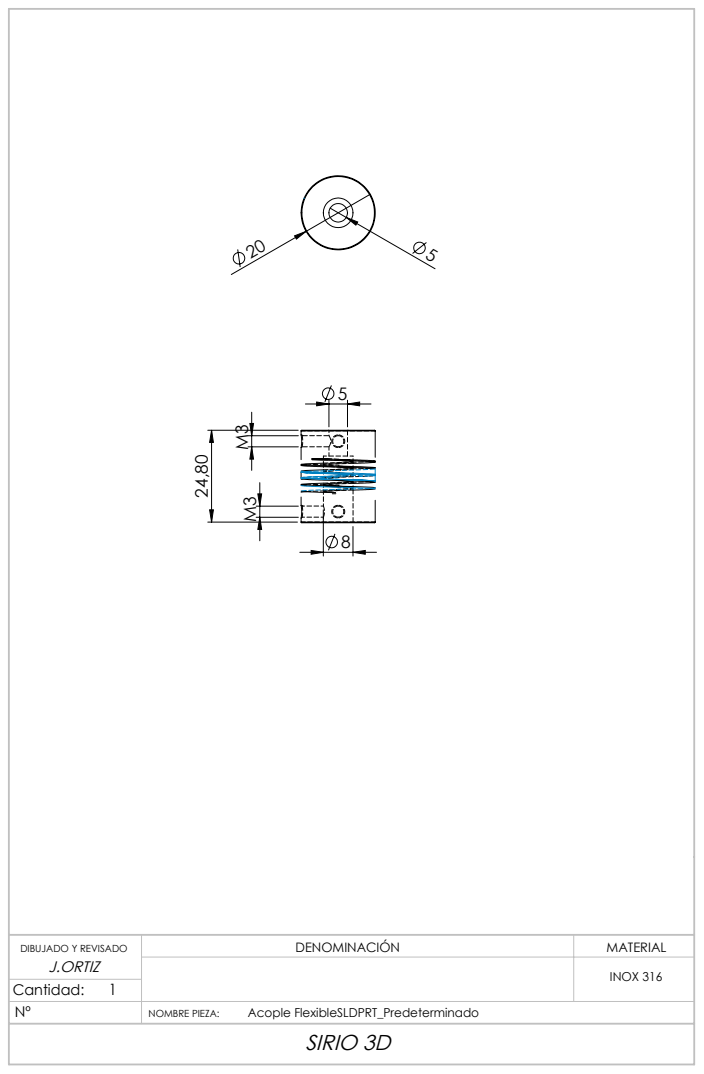
[picture p39: page 1]
SIRIO 3D

DIBUJADO Y REVISADO J.ORTIZ | DENOMINACIÓN | MATERIAL

INOX 316

Nº | NOMBRE PIEZA: Acople FlexibleSLDPRT_Predeterminado
