SIRIO-VENTILATOR/sirio-hardware/SIRIO v5 INDUSTRIAL/PDFs/BASE DE HUSILLO.PDF

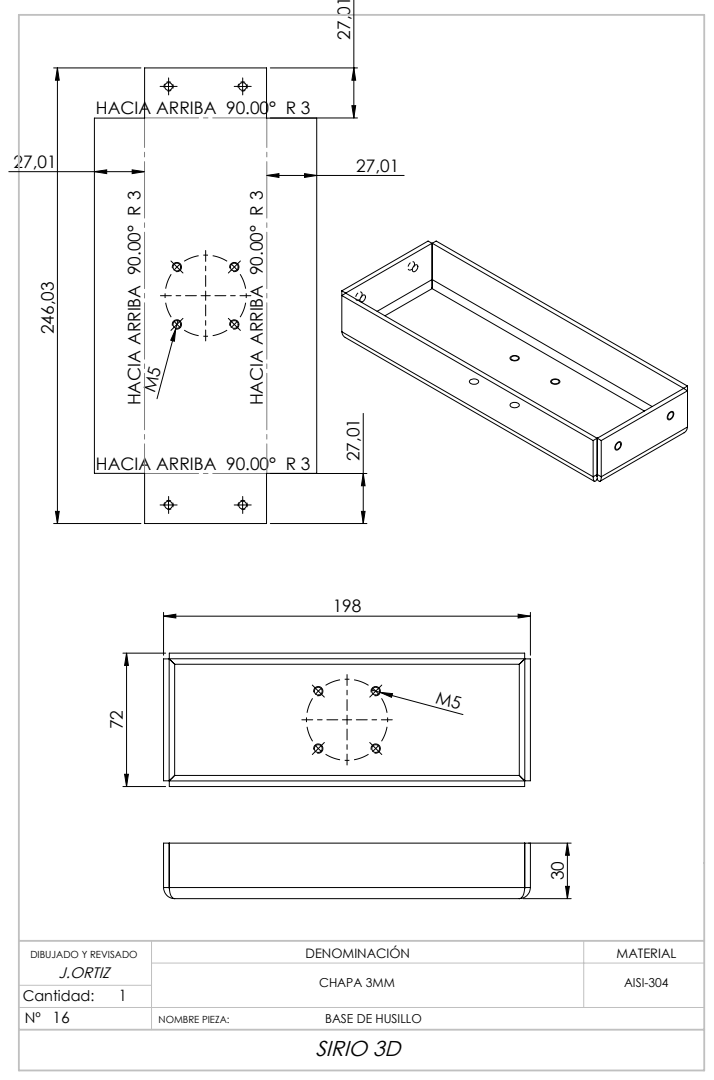
[picture p40: page 1]
HACIA ARRIBA 90.00° R 3; SIRIO 3D

DIBUJADO Y REVISADO J.ORTIZ | DENOMINACIÓN | MATERIAL

CHAPA 3MM | AISI-304

Nº 16 | NOMBRE PIEZA: BASE DE HUSILLO
