SIRIO-VENTILATOR/sirio-hardware/SIRIO v5 INDUSTRIAL/PDFs/CAÑONERA.PDF

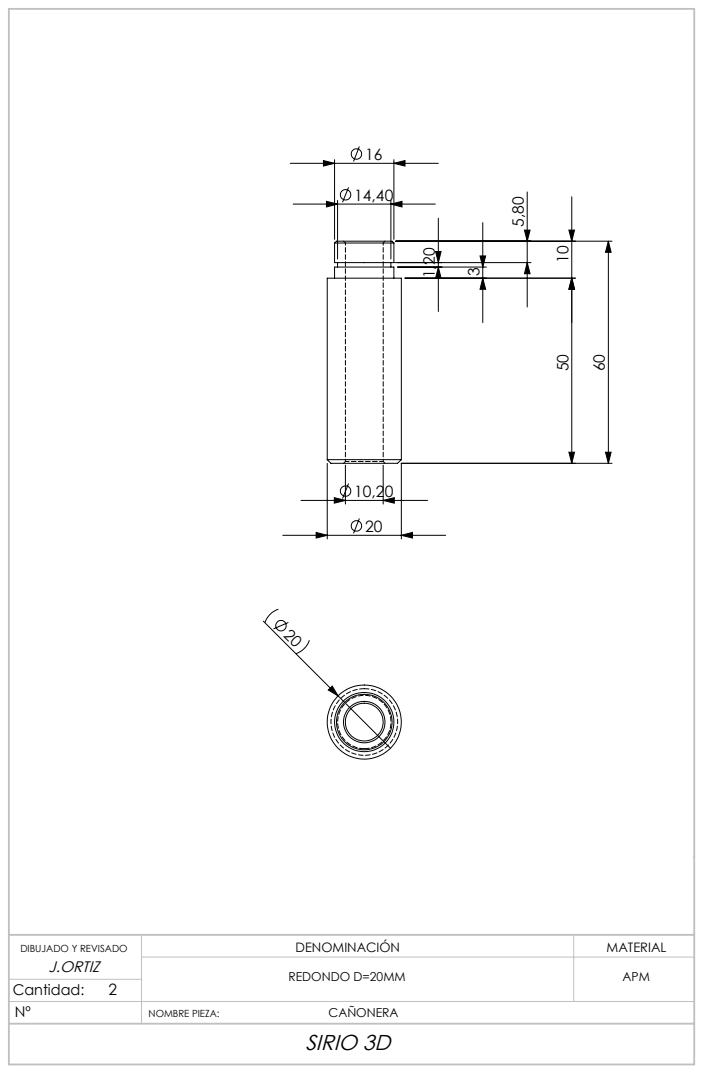
[picture p41: page 1]
SIRIO 3D

DIBUJADO Y REVISADO J.ORTIZ | DENOMINACIÓN | MATERIAL

REDONDO D=20MM | APM

Nº | NOMBRE PIEZA: CAÑONERA
