SIRIO-VENTILATOR/sirio-hardware/SIRIO v5 INDUSTRIAL/PDFs/CENTRADOR.PDF

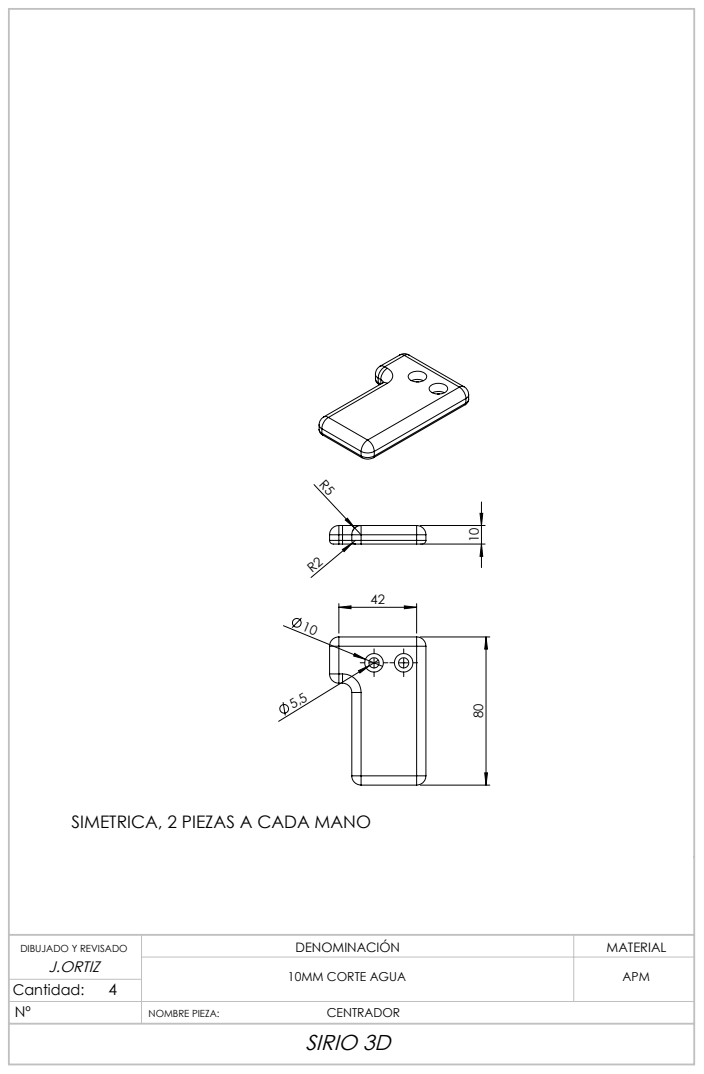
[picture p42: page 1]
SIRIO 3D

SIMETRICA, 2 PIEZAS A CADA MANO

DIBUJADO Y REVISADO J.ORTIZ | DENOMINACIÓN | MATERIAL

10MM CORTE AGUA | APM

Nº | NOMBRE PIEZA: CENTRADOR
