SIRIO-VENTILATOR/sirio-hardware/SIRIO v5 INDUSTRIAL/PDFs/collarin.PDF

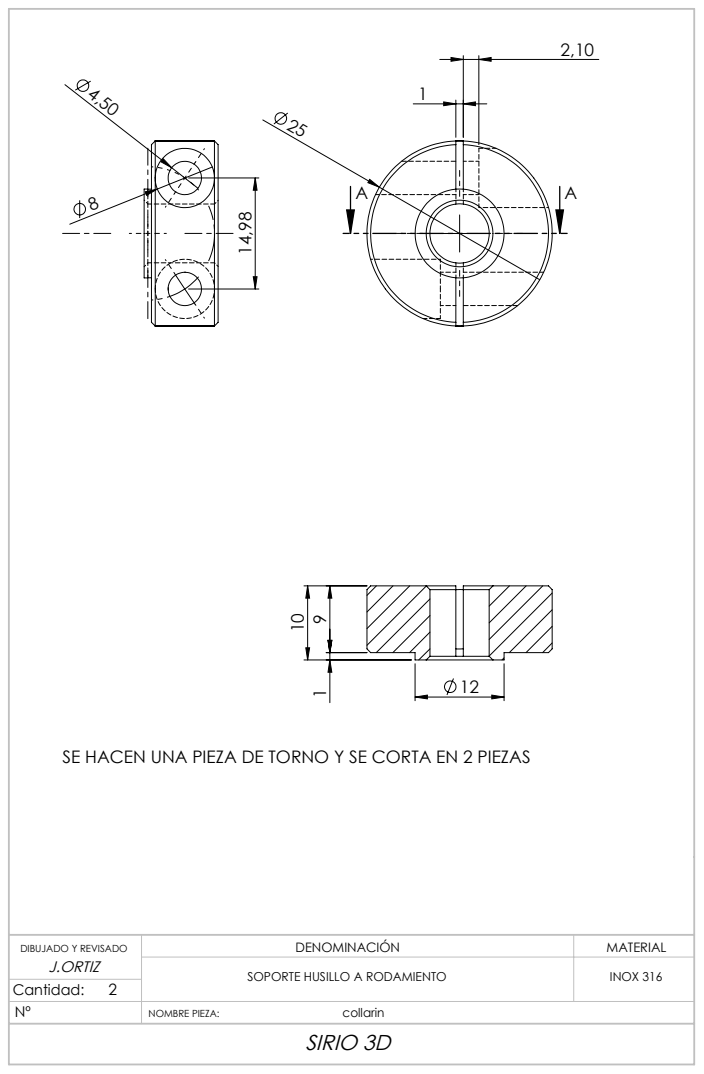
[picture p43: page 1]
SIRIO 3D

SE HACEN UNA PIEZA DE TORNO Y SE CORTA EN 2 PIEZAS

DIBUJADO Y REVISADO J.ORTIZ | DENOMINACIÓN | MATERIAL

SOPORTE HUSILLO A RODAMIENTO | INOX 316

Nº | NOMBRE PIEZA: collarin
