SIRIO-VENTILATOR/sirio-hardware/SIRIO v5 INDUSTRIAL/PDFs/cuerpo.PDF

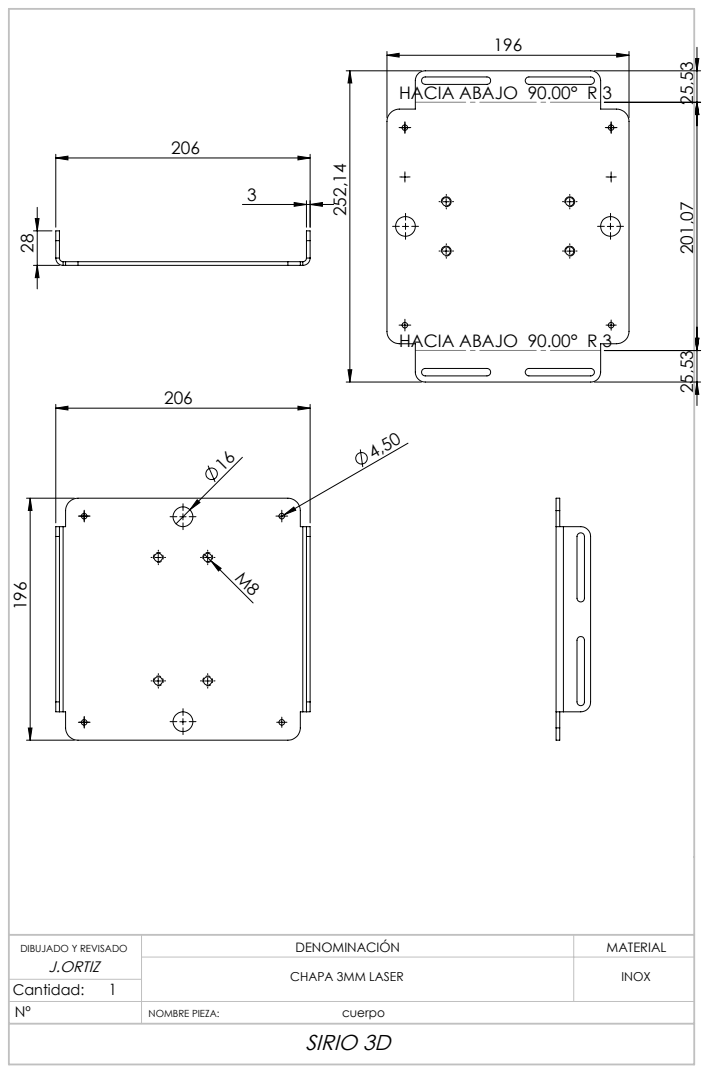
[picture p44: page 1]
HACIA ABAJO 90.00° R 3; SIRIO 3D

DIBUJADO Y REVISADO J.ORTIZ | DENOMINACIÓN | MATERIAL

CHAPA 3MM LASER | INOX

Nº | NOMBRE PIEZA: cuerpo
