SIRIO-VENTILATOR/sirio-hardware/SIRIO v5 INDUSTRIAL/PDFs/DST_JFRM_1315DS6_35x25_4_1.PDF

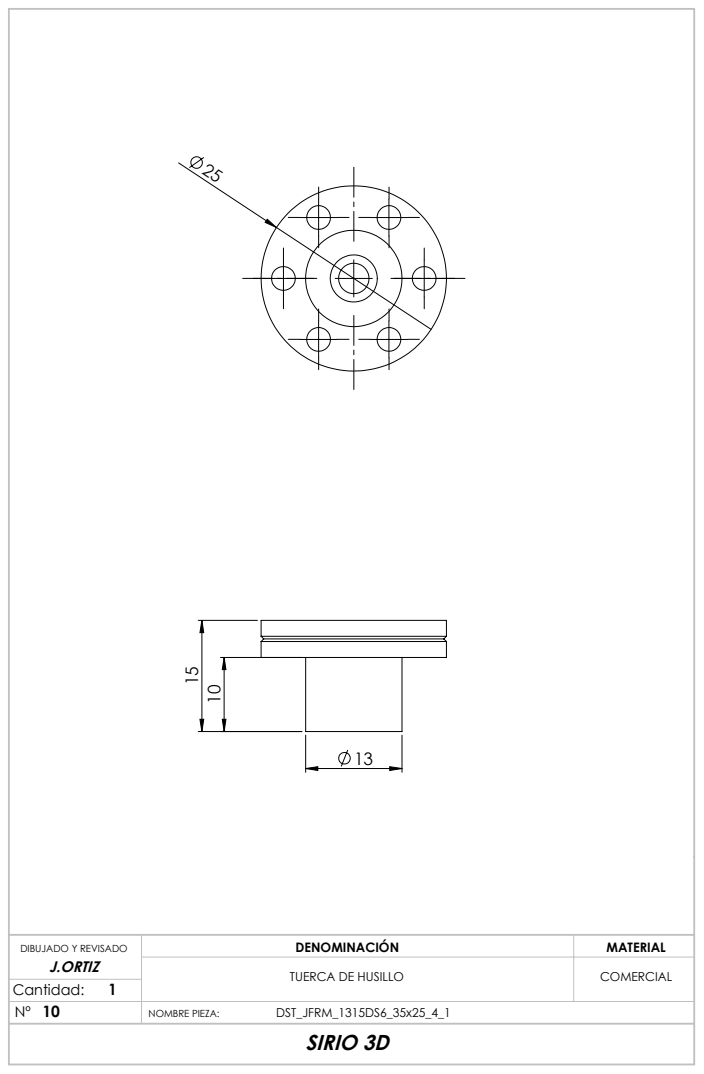
[picture p45: page 1]
SIRIO 3D

DIBUJADO Y REVISADO J.ORTIZ | DENOMINACIÓN | MATERIAL

TUERCA DE HUSILLO | COMERCIAL

10 Nº | NOMBRE PIEZA: DST_JFRM_1315DS6_35x25_4_1
