SIRIO-VENTILATOR/sirio-hardware/SIRIO v5 INDUSTRIAL/PDFs/DST_JFRM_2020ds8x15.PDF

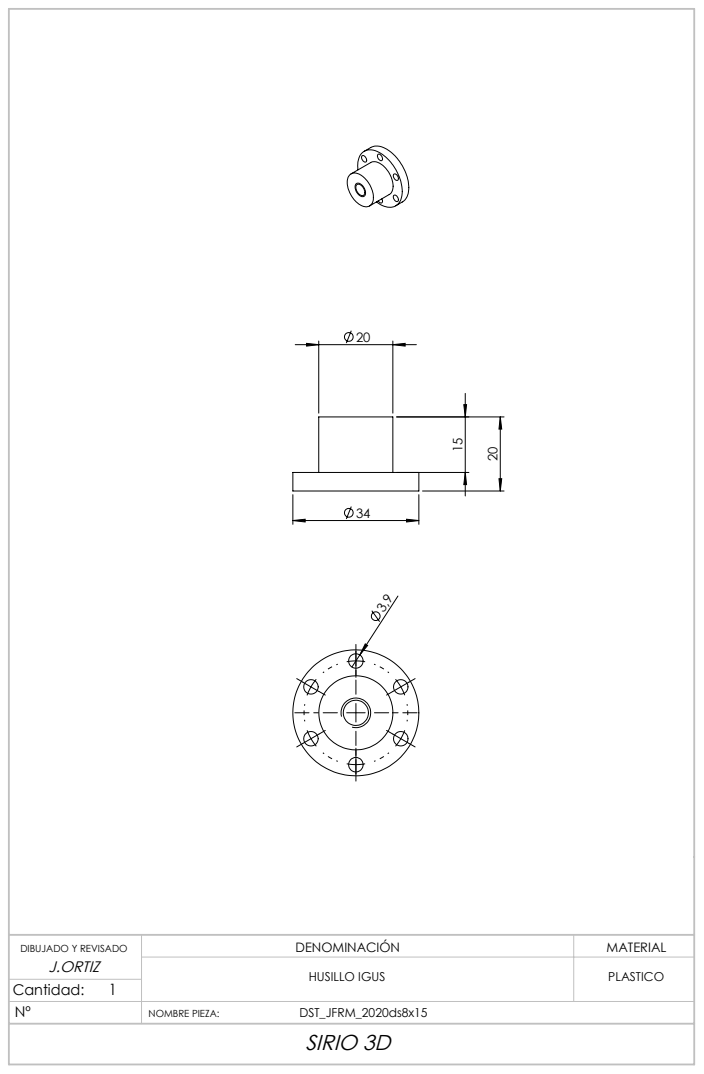
[picture p46: page 1]
SIRIO 3D

DIBUJADO Y REVISADO J.ORTIZ | DENOMINACIÓN | MATERIAL

HUSILLO IGUS | PLASTICO

Nº | NOMBRE PIEZA: DST_JFRM_2020ds8x15
