SIRIO-VENTILATOR/sirio-hardware/SIRIO v5 INDUSTRIAL/PDFs/EMPUJADOR INFERIOR.PDF

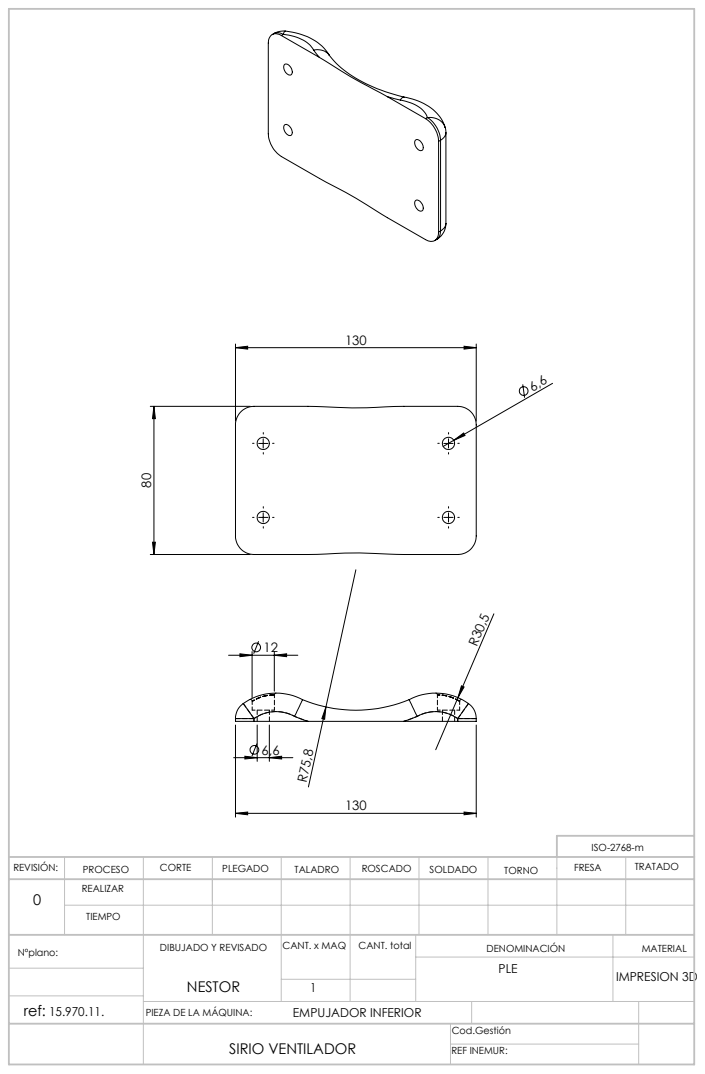
[picture p47: page 1]
SIRIO VENTILADOR; IMPRESION 3D; REF INEMUR:

REVISIÓN: | PROCESO | CORTE | PLEGADO | TALADRO | ROSCADO | SOLDADO | TORNO | FRESA | TRATADO
0 | REALIZAR

TIEMPO

Nºplano: | DIBUJADO Y REVISADO NESTOR | | CANT. x MAQ | CANT. total | DENOMINACIÓN | | MATERIAL

PLE

PIEZA DE LA MÁQUINA: | EMPUJADOR INFERIOR

Cod.Gestión
