SIRIO-VENTILATOR/sirio-hardware/SIRIO v5 INDUSTRIAL/PDFs/GUIA.PDF

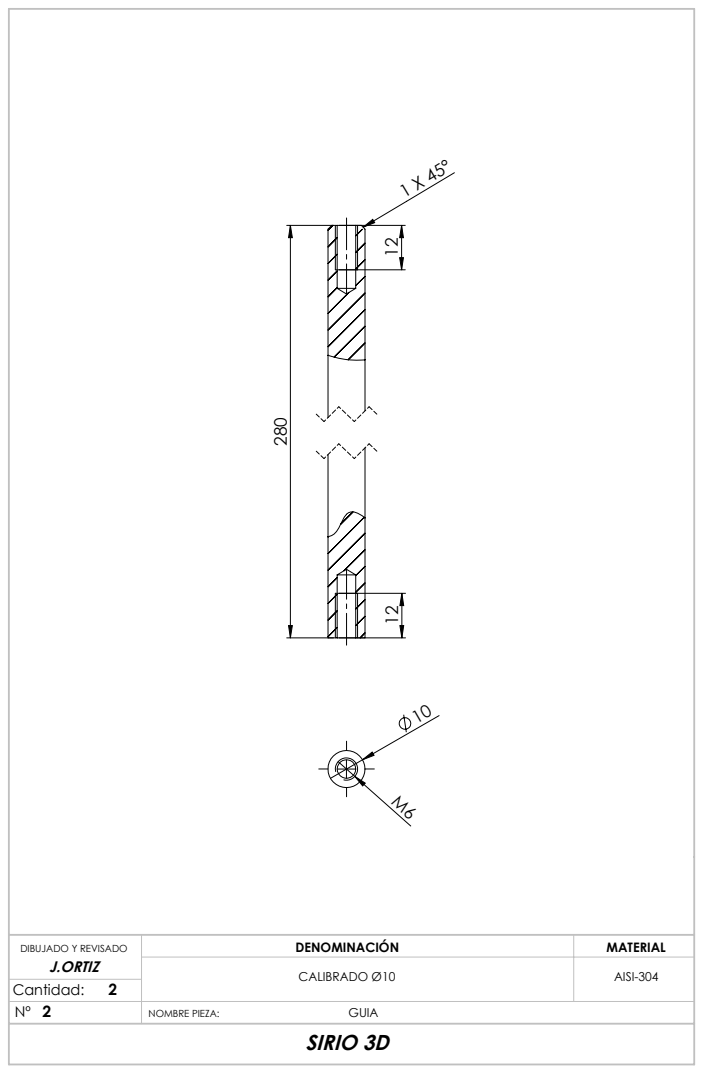
[picture p48: page 1]
SIRIO 3D

DIBUJADO Y REVISADO J.ORTIZ | DENOMINACIÓN | MATERIAL

CALIBRADO Ø10 | AISI-304

2 Nº | NOMBRE PIEZA: GUIA
