SIRIO-VENTILATOR/sirio-hardware/SIRIO v5 INDUSTRIAL/PDFs/HUSILLO_IGUS_8X15.PDF

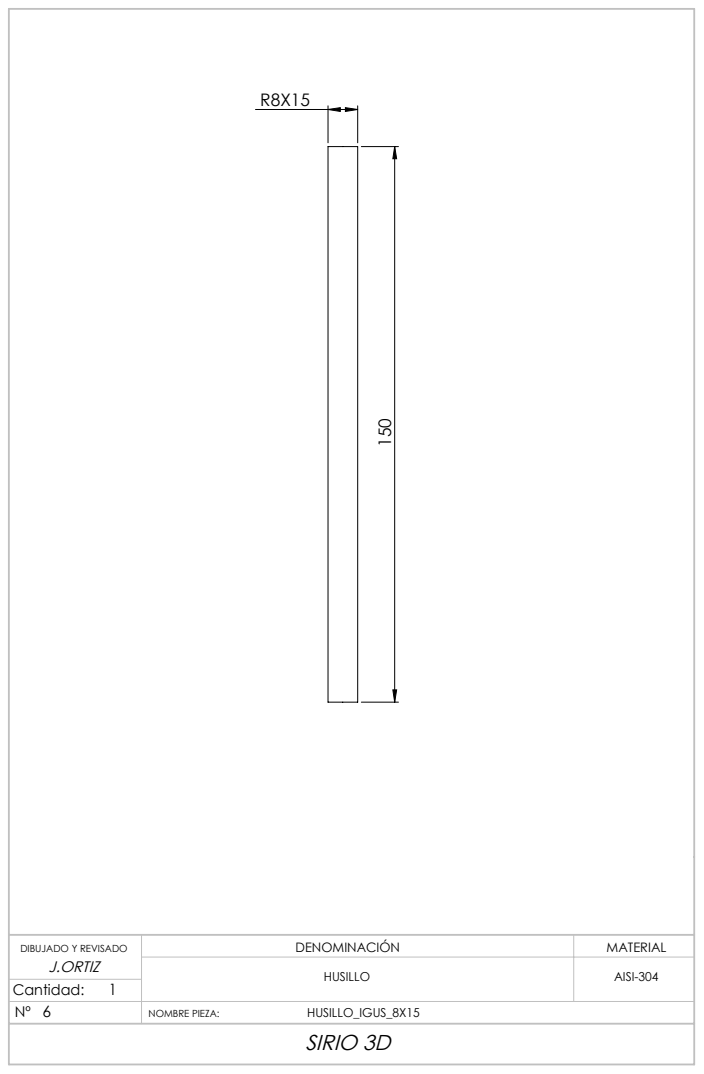
[picture p49: page 1]
SIRIO 3D

DIBUJADO Y REVISADO J.ORTIZ | DENOMINACIÓN | MATERIAL

HUSILLO | AISI-304

Nº 6 | NOMBRE PIEZA: HUSILLO_IGUS_8X15
