SIRIO-VENTILATOR/sirio-hardware/SIRIO v5 INDUSTRIAL/PDFs/LATERAL CAJON.PDF

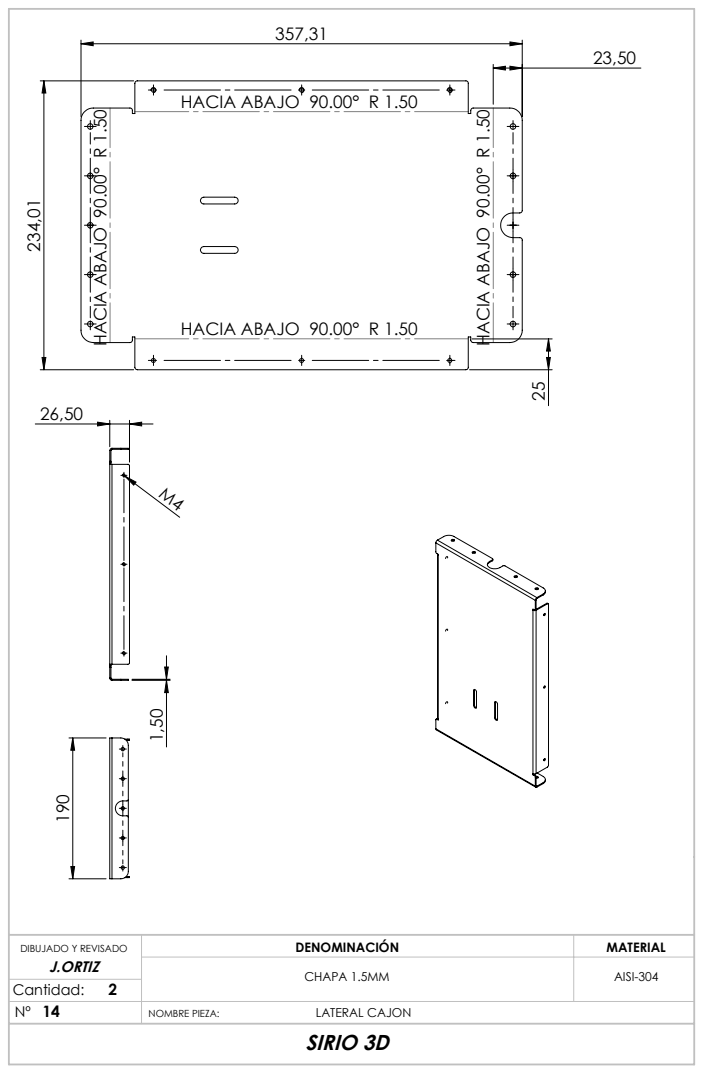
[picture p50: page 1]
HACIA ABAJO 90.00° R 1.50; SIRIO 3D

DIBUJADO Y REVISADO J.ORTIZ | DENOMINACIÓN | MATERIAL

CHAPA 1.5MM | AISI-304

14 Nº | NOMBRE PIEZA: LATERAL CAJON
