SIRIO-VENTILATOR/sirio-hardware/SIRIO v5 INDUSTRIAL/PDFs/Nema17Motor - Copy.PDF

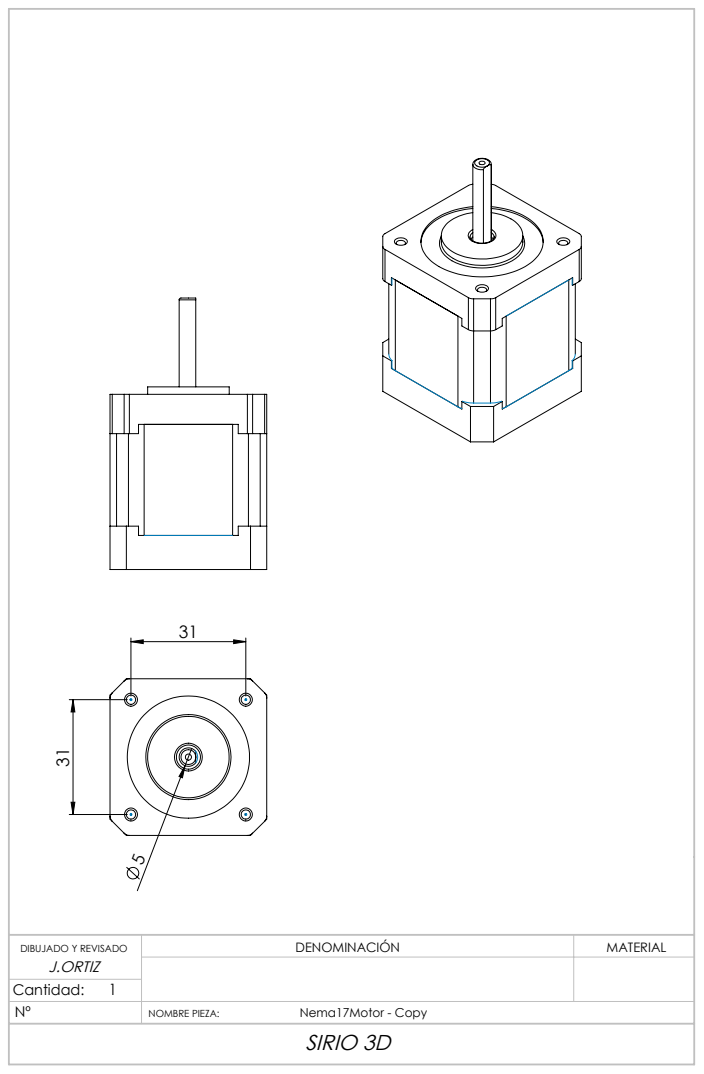
[picture p51: page 1]
DIBUJADO Y REVISADO; DENOMINACIÓN; MATERIAL; NOMBRE PIEZA:; Nema17Motor - Copy; SIRIO 3D
