SIRIO-VENTILATOR/sirio-hardware/SIRIO v5 INDUSTRIAL/PDFs/ROD_608.PDF

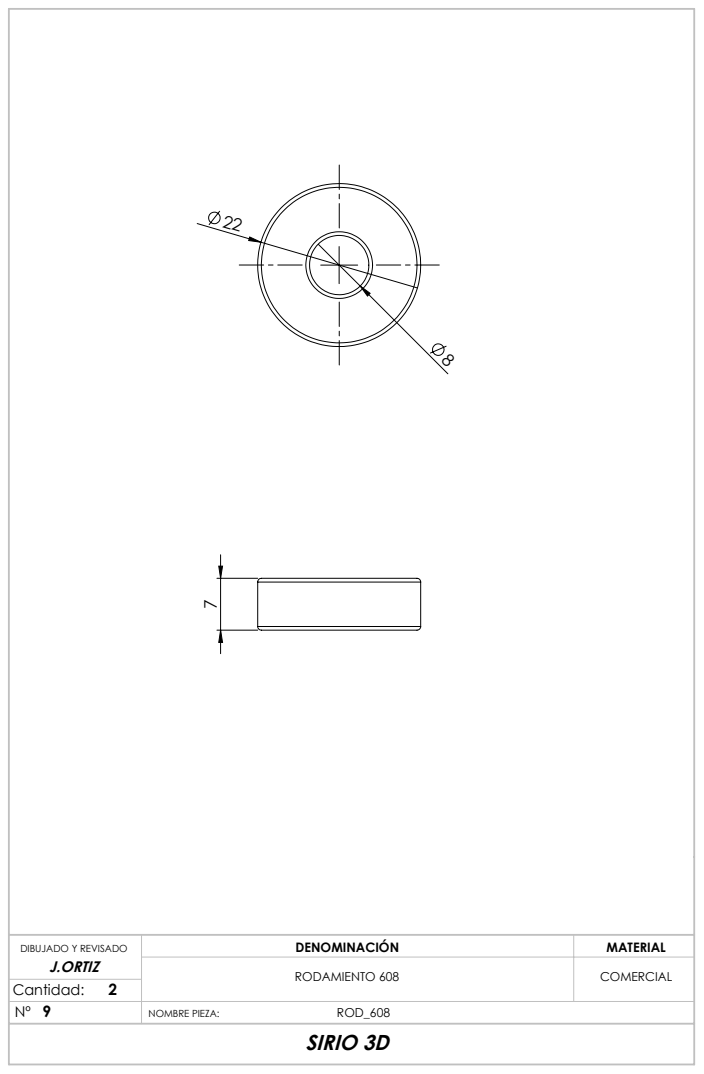
[picture p52: page 1]
SIRIO 3D

DIBUJADO Y REVISADO J.ORTIZ | DENOMINACIÓN | MATERIAL

RODAMIENTO 608 | COMERCIAL

9 Nº | NOMBRE PIEZA: ROD_608
