SIRIO-VENTILATOR/sirio-hardware/SIRIO v5 INDUSTRIAL/PDFs/ROD_728.PDF

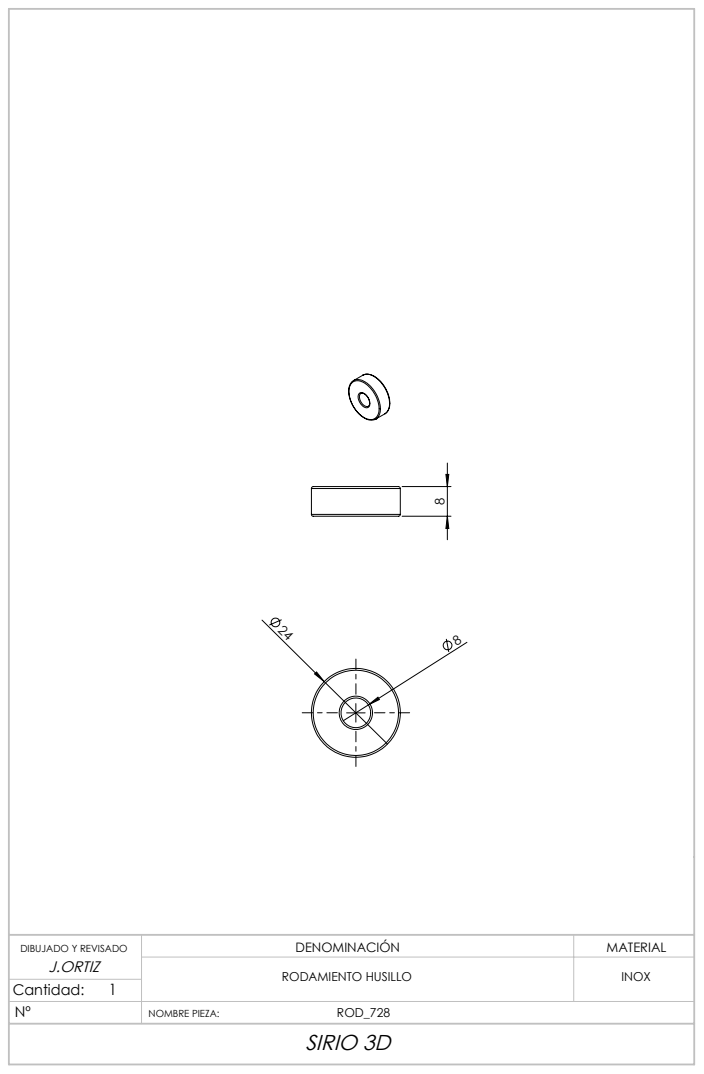
[picture p53: page 1]
SIRIO 3D

DIBUJADO Y REVISADO J.ORTIZ | DENOMINACIÓN | MATERIAL

RODAMIENTO HUSILLO | INOX

Nº | NOMBRE PIEZA: ROD_728
