SIRIO-VENTILATOR/sirio-hardware/SIRIO v5 INDUSTRIAL/PDFs/SEPARADOR CILINDRO.PDF

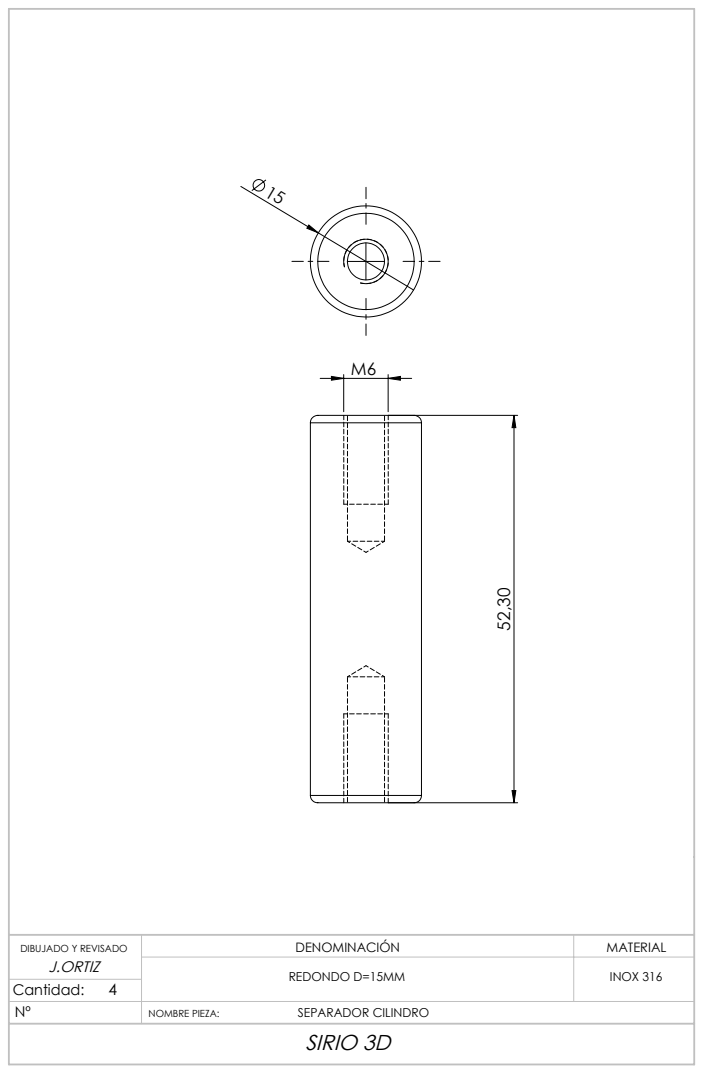
[picture p54: page 1]
SIRIO 3D

DIBUJADO Y REVISADO J.ORTIZ | DENOMINACIÓN | MATERIAL

REDONDO D=15MM | INOX 316

Nº | NOMBRE PIEZA: SEPARADOR CILINDRO
