SIRIO-VENTILATOR/sirio-hardware/SIRIO v5 INDUSTRIAL/PDFs/SOPORT_HUSILLO_SUP.PDF

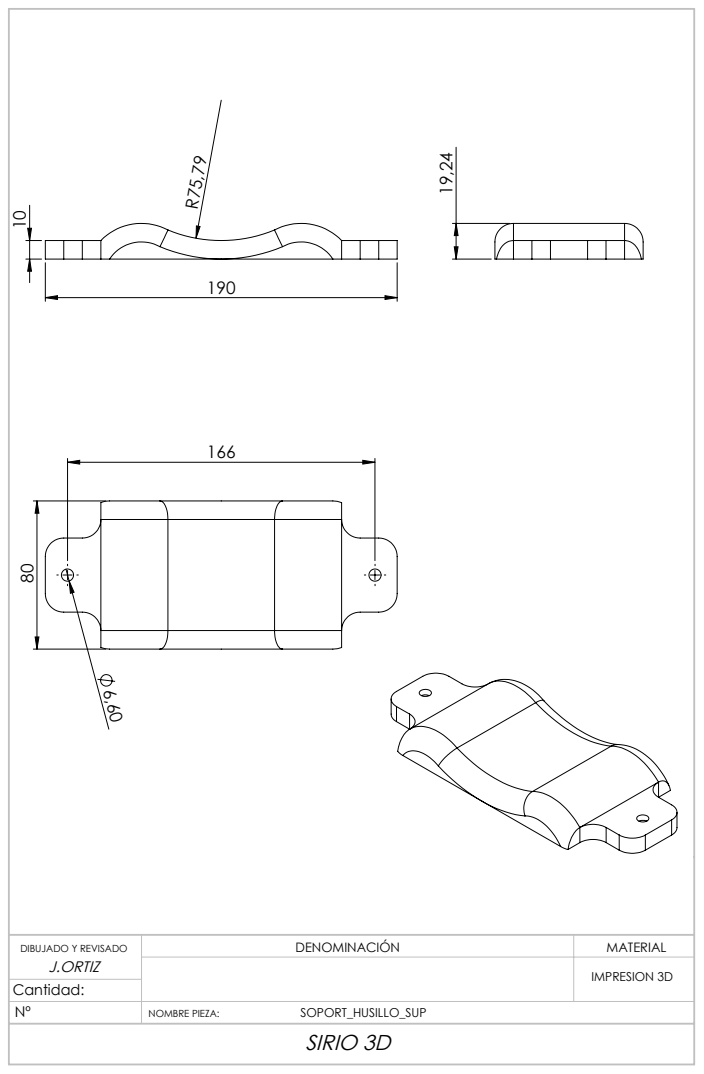
[picture p55: page 1]
SIRIO 3D

DIBUJADO Y REVISADO J.ORTIZ | DENOMINACIÓN | MATERIAL

IMPRESION 3D

Nº | NOMBRE PIEZA: SOPORT_HUSILLO_SUP
