SIRIO-VENTILATOR/sirio-hardware/SIRIO v5 INDUSTRIAL/PDFs/SOPORTE HUSILLO.PDF

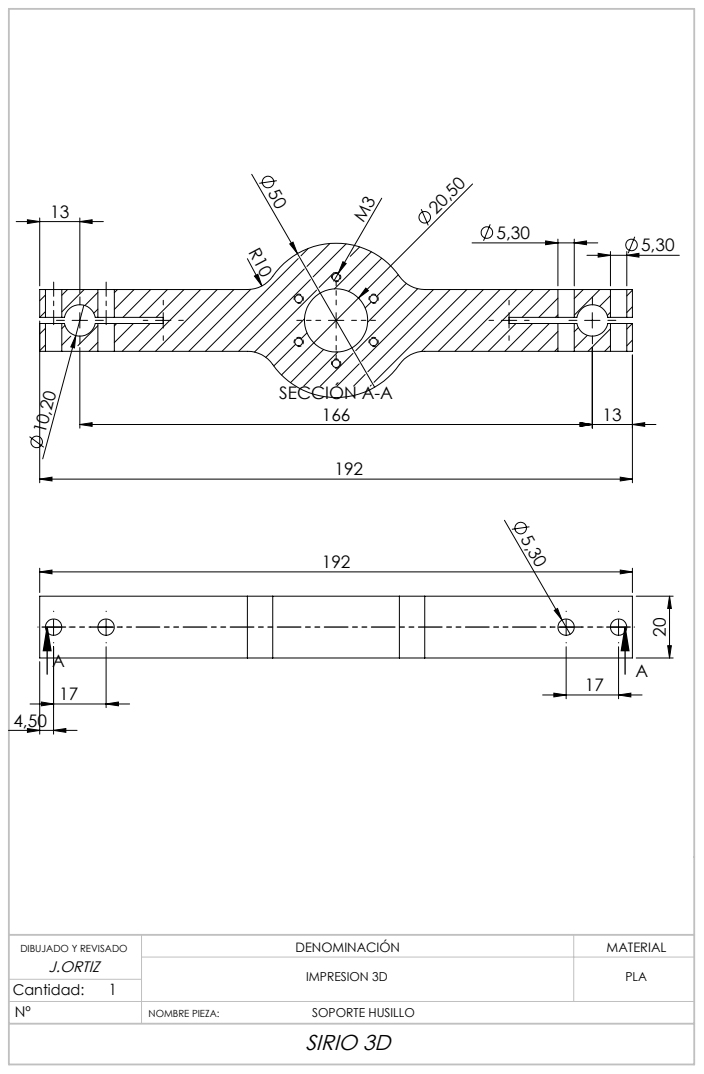
[picture p56: page 1]
SECCIÓN A-A; SIRIO 3D

DIBUJADO Y REVISADO J.ORTIZ | DENOMINACIÓN | MATERIAL

IMPRESION 3D | PLA

Nº | NOMBRE PIEZA: SOPORTE HUSILLO
