SIRIO-VENTILATOR/sirio-hardware/SIRIO v5 INDUSTRIAL/PDFs/SOPORTE_MOTOR.PDF

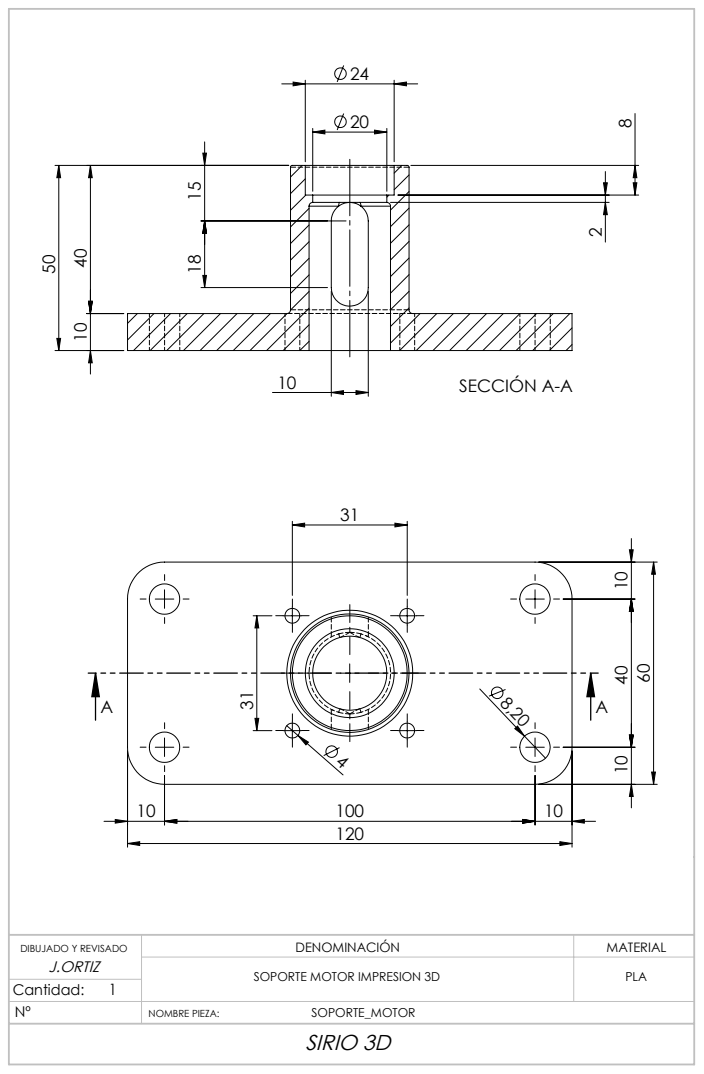
[picture p57: page 1]
SECCIÓN A-A; SIRIO 3D

DIBUJADO Y REVISADO J.ORTIZ | DENOMINACIÓN | MATERIAL

SOPORTE MOTOR IMPRESION 3D | PLA

Nº | NOMBRE PIEZA: SOPORTE_MOTOR
