SIRIO-VENTILATOR/sirio-hardware/SIRIO v5 INDUSTRIAL/PDFs/TAPA FRONTAL.PDF

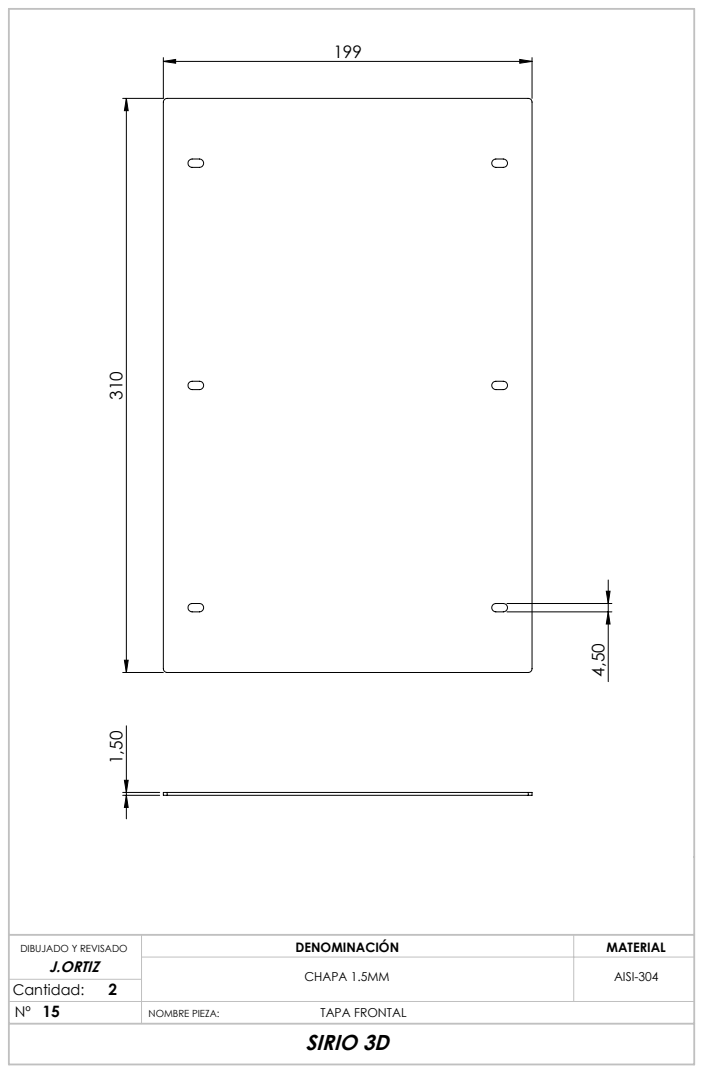
[picture p58: page 1]
SIRIO 3D

DIBUJADO Y REVISADO J.ORTIZ | DENOMINACIÓN | MATERIAL

CHAPA 1.5MM | AISI-304

15 Nº | NOMBRE PIEZA: TAPA FRONTAL
