SIRIO-VENTILATOR/sirio-hardware/SIRIO v5 INDUSTRIAL/PDFs/FIJACION CENTRADOR.PDF

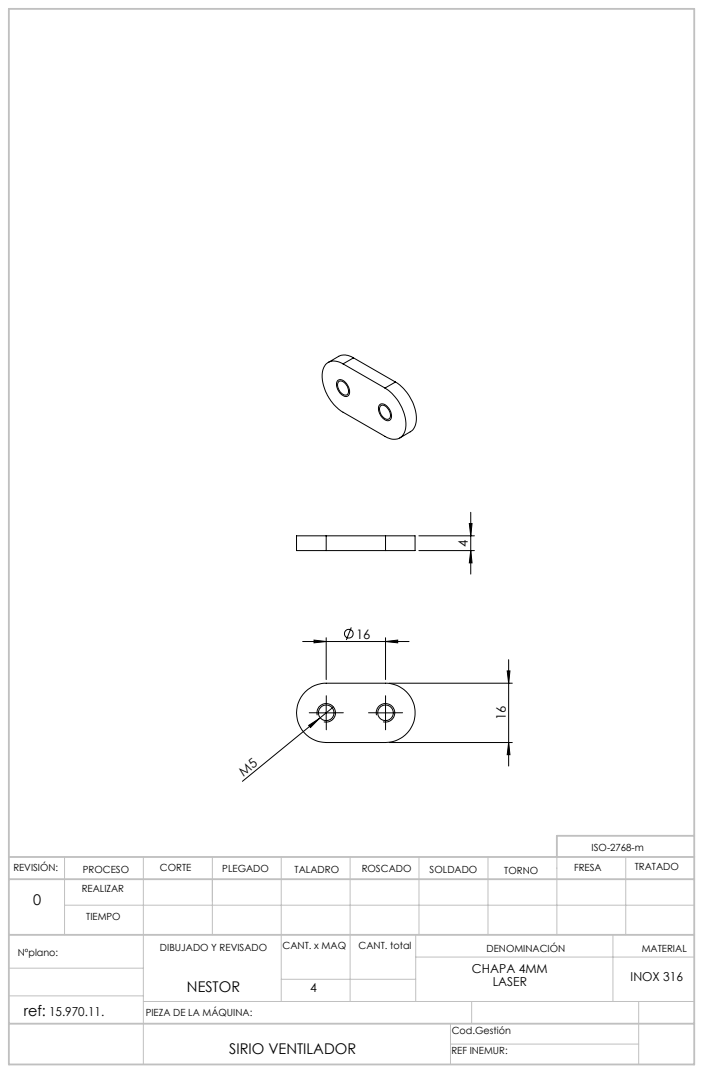
[picture p1: page 1]
SIRIO VENTILADOR; REF INEMUR:

REVISIÓN: | PROCESO | CORTE | PLEGADO | TALADRO | ROSCADO | SOLDADO | TORNO | FRESA | TRATADO
0 | REALIZAR

TIEMPO

Nºplano: | DIBUJADO Y REVISADO NESTOR | | CANT. x MAQ | CANT. total | DENOMINACIÓN | | MATERIAL

CHAPA 4MM LASER | INOX 316

PIEZA DE LA MÁQUINA:

Cod.Gestión
