SIRIO-VENTILATOR/sirio-hardware/SIRIO v5 INDUSTRIAL/PDFs/FIJACION CENTRADOR.SLDPRT

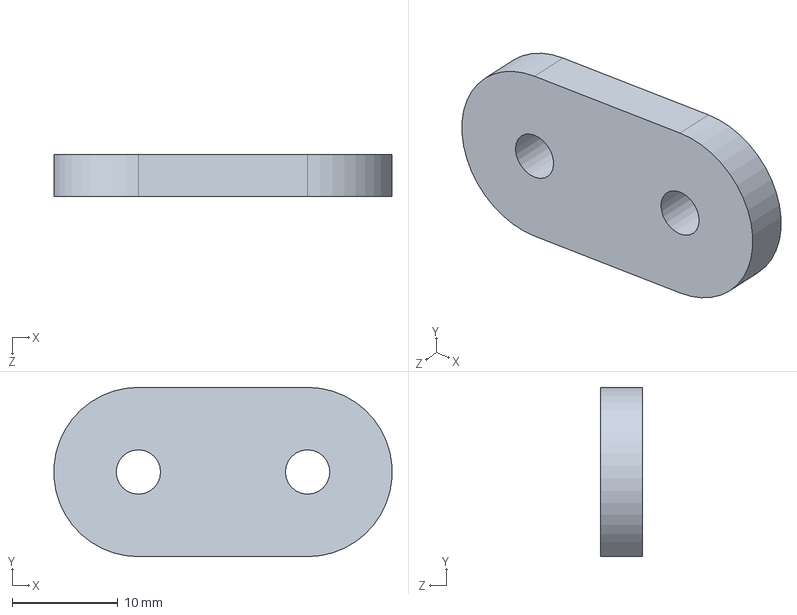
[picture p1: CAD file, 2020-03-29]
SIRIO v5 INDUSTRIAL/PDFs/FIJACION CENTRADOR.SLDPRT
32.0 x 16.0 x 4.00 mm
